refob/herculitoHardware/README.md

# herculitoHardware
 Decription of the hardware used by the herculito robot arm
 
 The herculito hardware consists of:
 * [Wemos D1 R32](/Wemos%20D1%20R32/README.md)
 * [CNC Shield V3](/CNC%20Shield%20V3/README.md)
 * [Extension board](/Extension/README.md)
 * [InterConn board](/InterConn/README.md)
 * [controlBox](/controlBox/README.md)
 * [Display](/Display/README.md)
 * [TMC2209 driver](/TMC2209/README.md)
 * [Connectors used by the herculito robot arm](/connectors/README.md)
 
 The 3D printable sources are available for download at [UltiMaker Thingiverse](https://www.thingiverse.com/thing:6422152).
