refob/herculitoHardware/controlBox/README.md

# controlBox

### BOM
* 1x [DC Power Plug Male 5.5x2.1mm Type C](https://www.aliexpress.com/item/1005003324016159.html)
* 1x [AC/DC switch-mode power supply 230V to 12V 10A 120W](https://www.ebay.de/itm/386404788570)
* 1x [Fan 50x50x15 mm](https://www.aliexpress.com/item/1005003960311498.html)

Solder power cables to the power plug

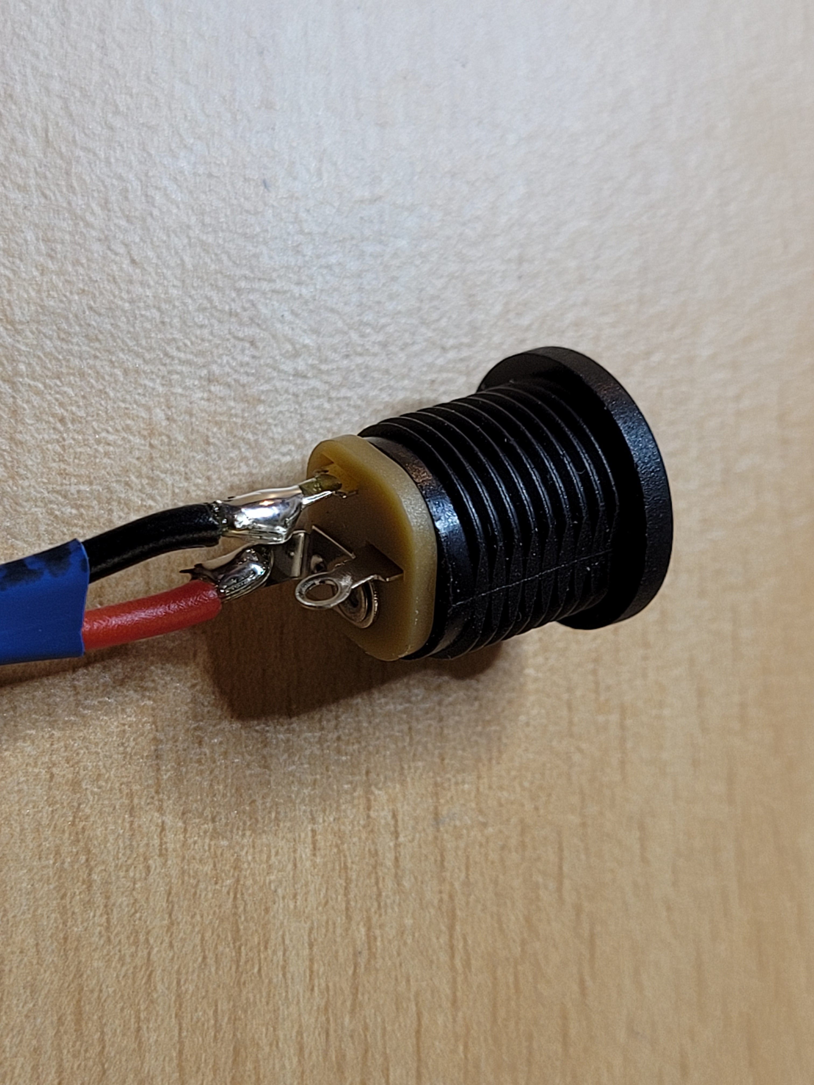
[picture p1: controlBox/power1.jpg]
power1


Fix the power plug to the controlBox

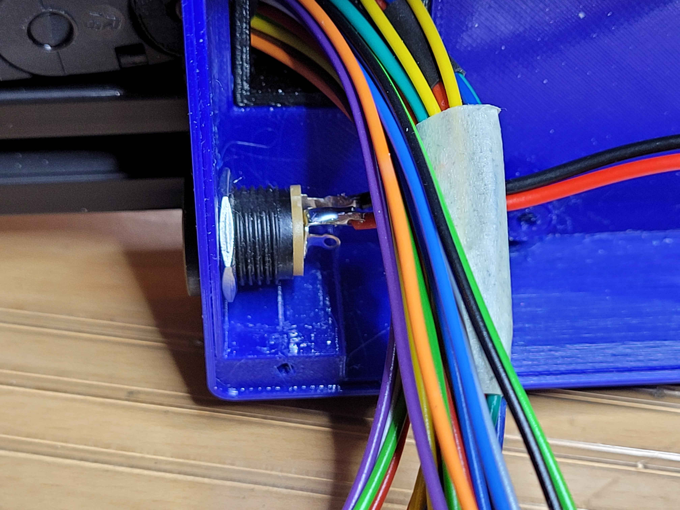
[picture p2: controlBox/power2.jpg]
power2


Place the InterConn

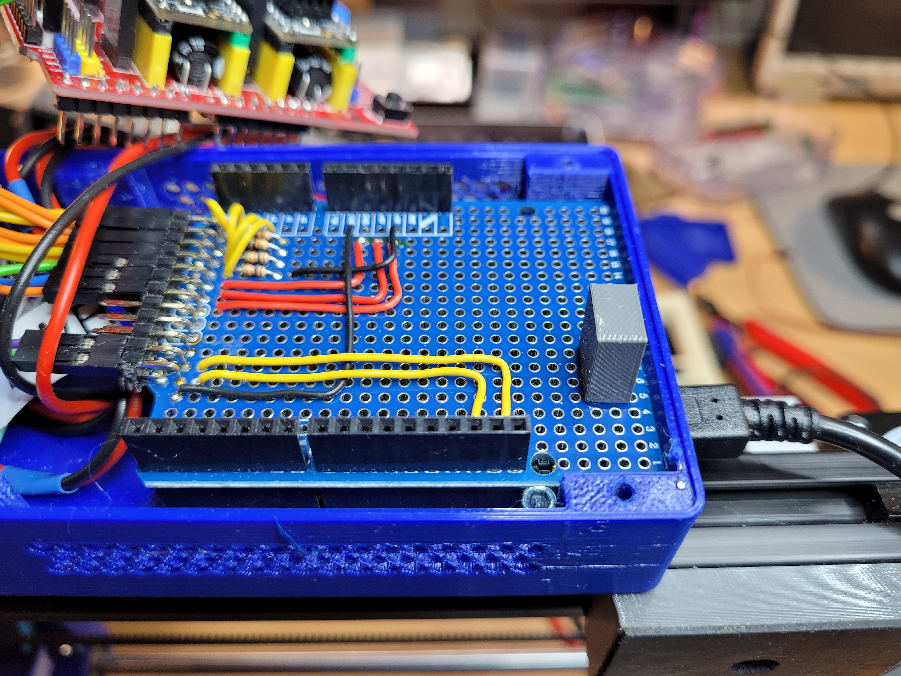
[picture p3: controlBox/place InterConn.jpg]
place InterConn


Place the CNC shield

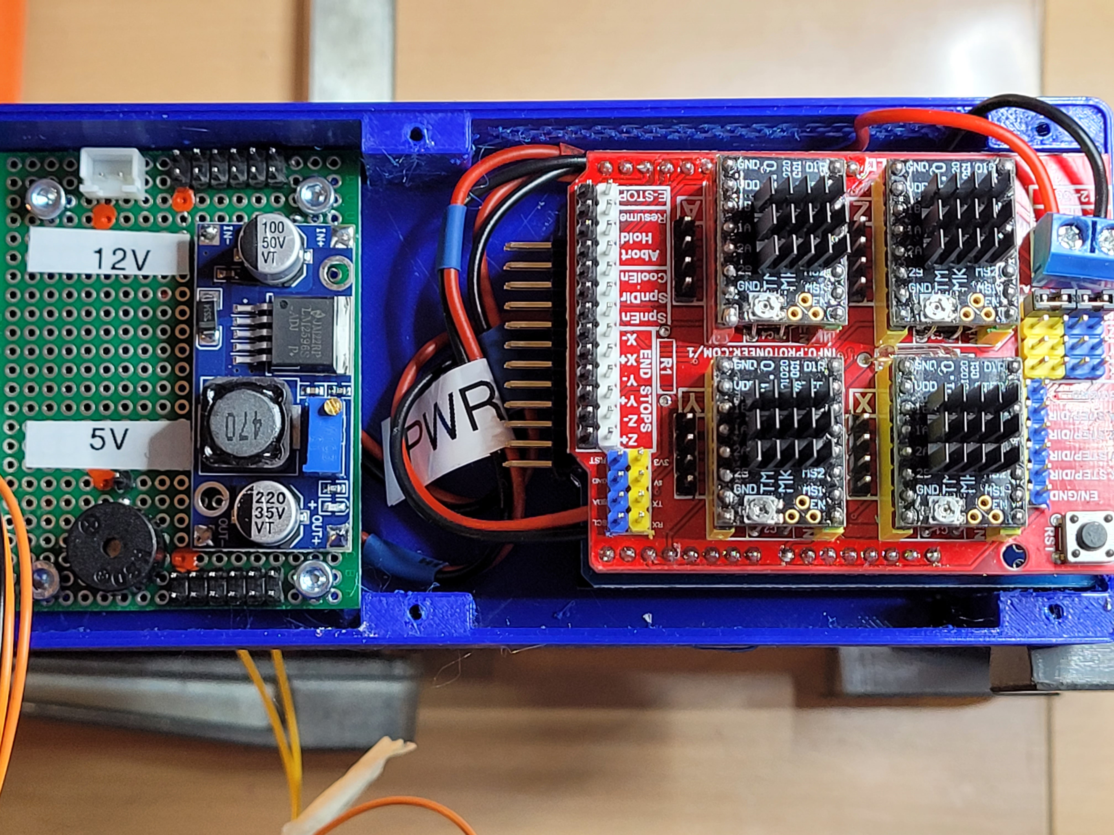
[picture p4: controlBox/place CNC SHield.jpg]
place CNC SHield


Place the drivers

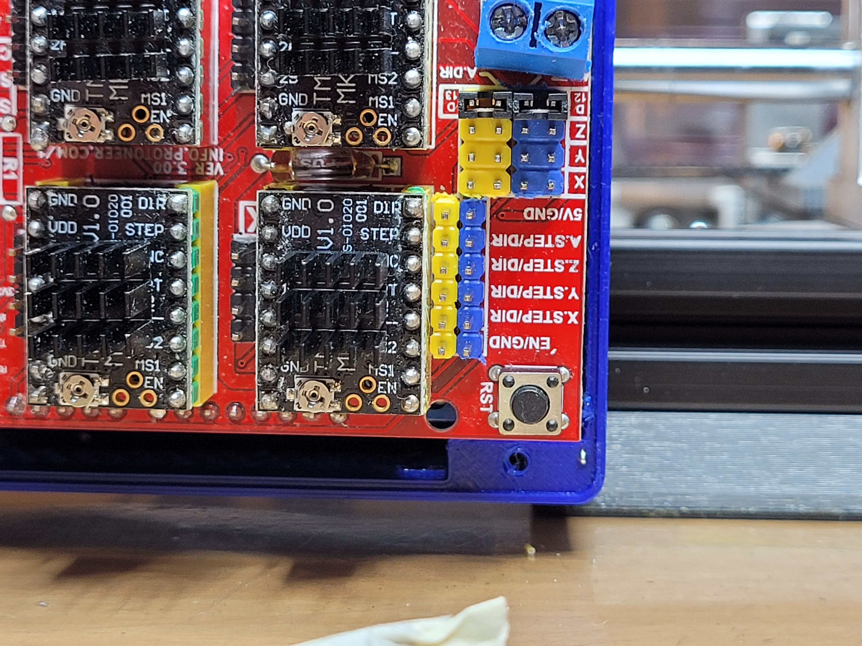
[picture p5: controlBox/place driver.jpg]
place driver


Place the Extensions

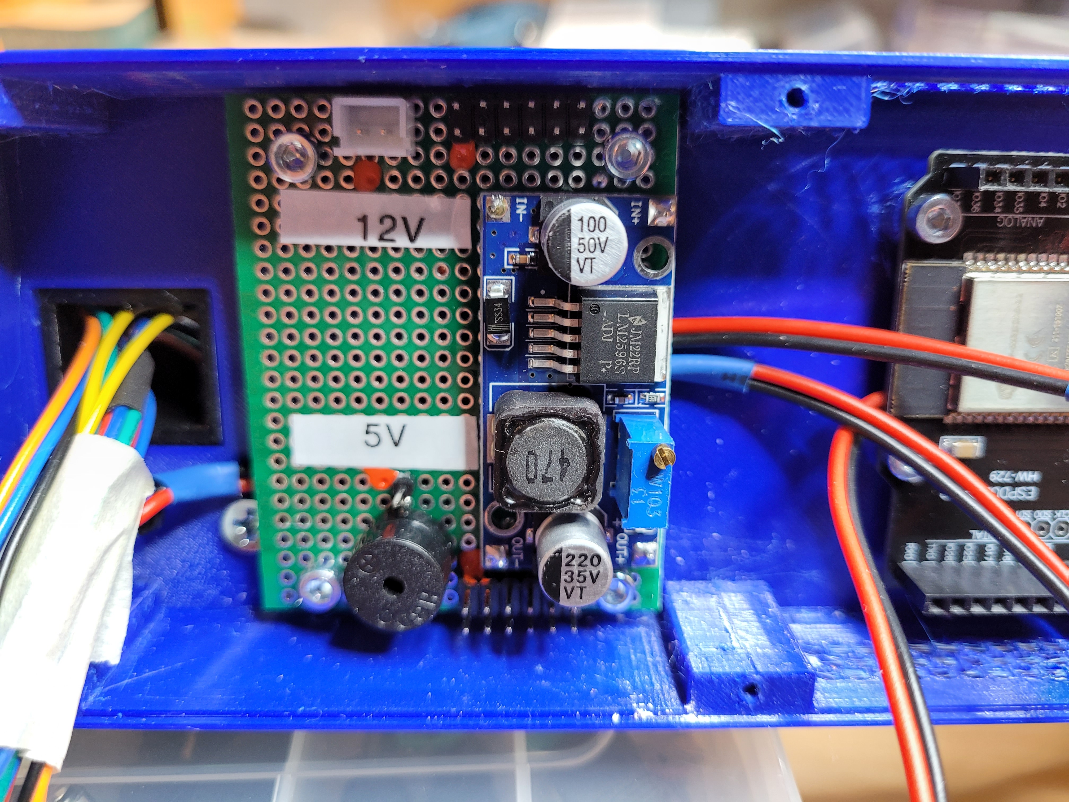
[picture p6: controlBox/place Extensions 1.jpg]
place Extensions


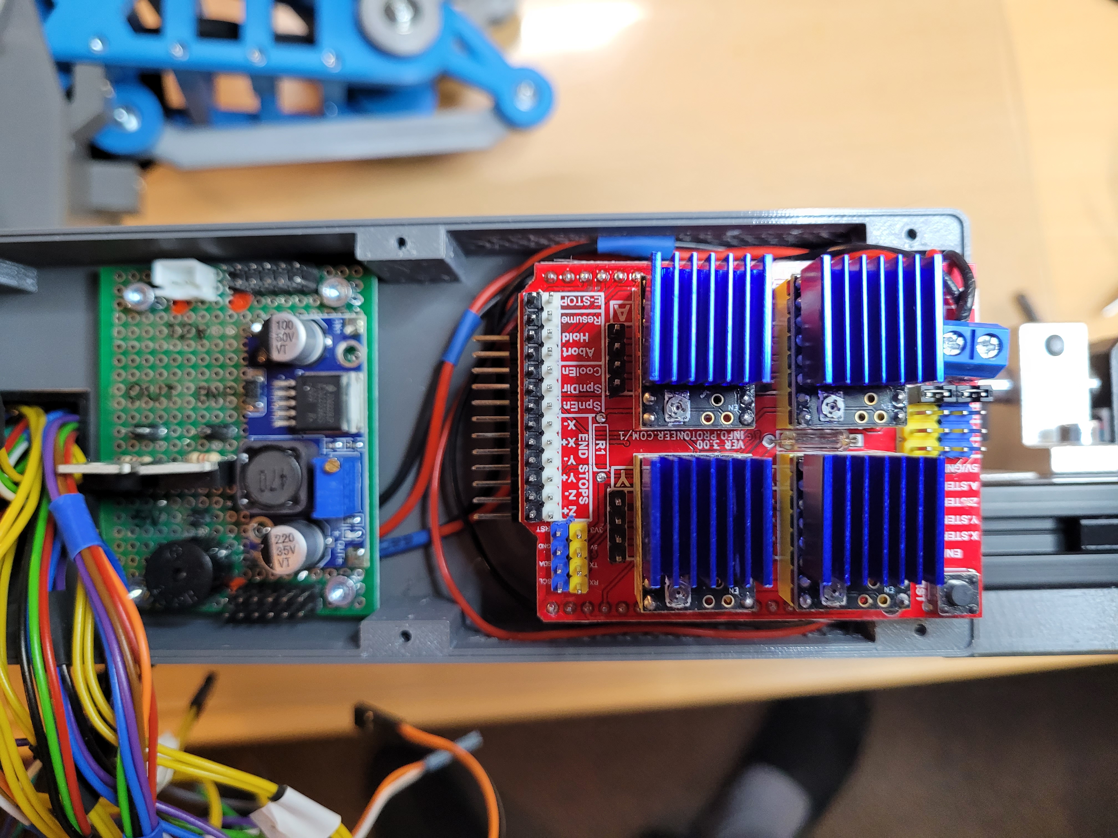
[picture p7: controlBox/place Extensions 2.jpg]
place Extensions


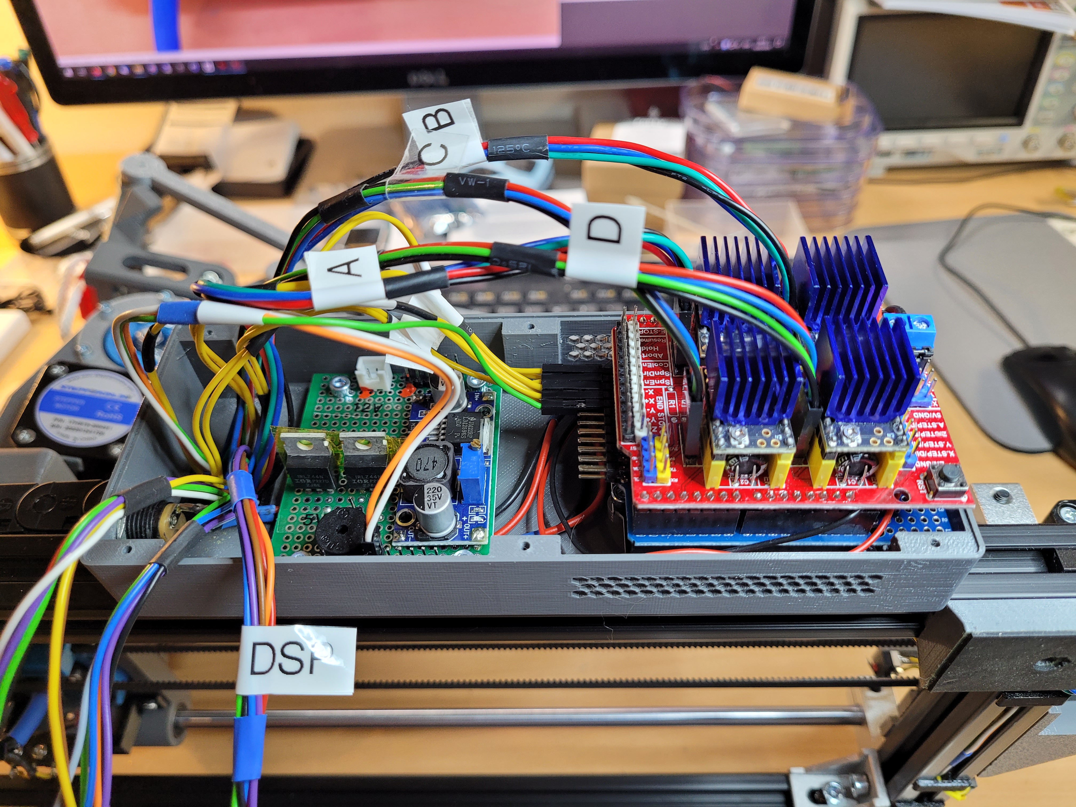
[picture p8: controlBox/place Extensions 3.jpg]
place Extensions


Locate the reset button on the lower right

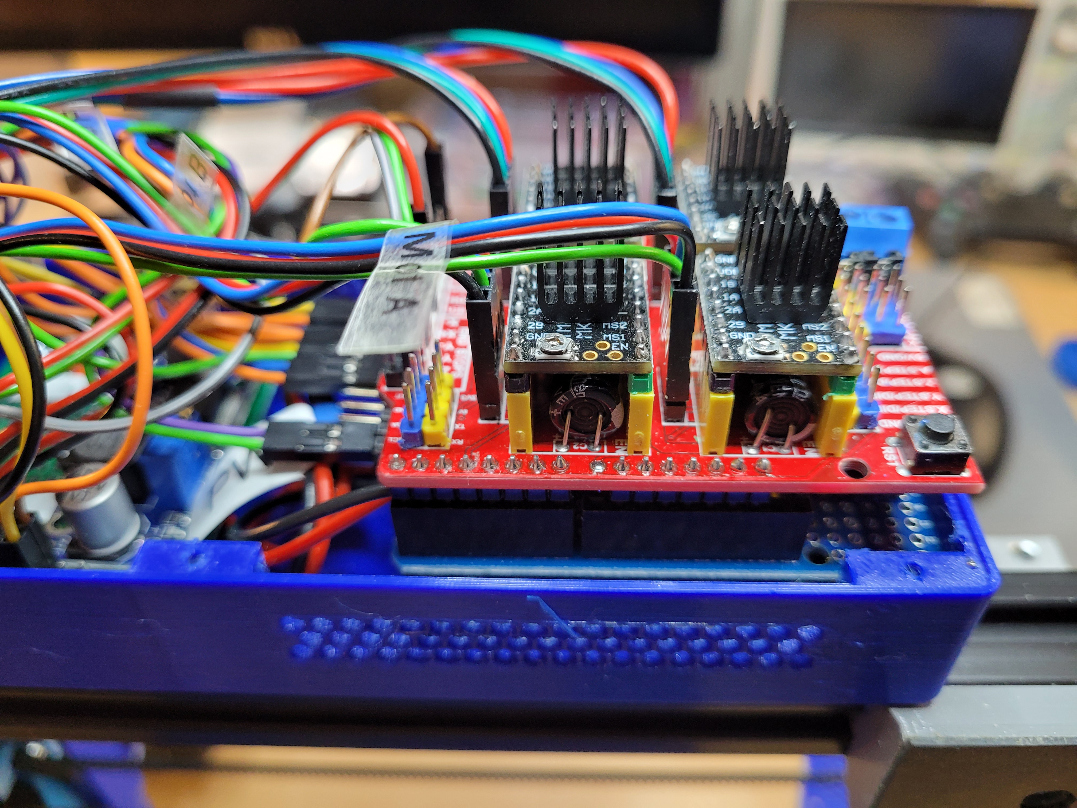
[picture p9: controlBox/reset1.jpg]
reset1


Place the controlBox-reset on the reset button before closing the controlBox

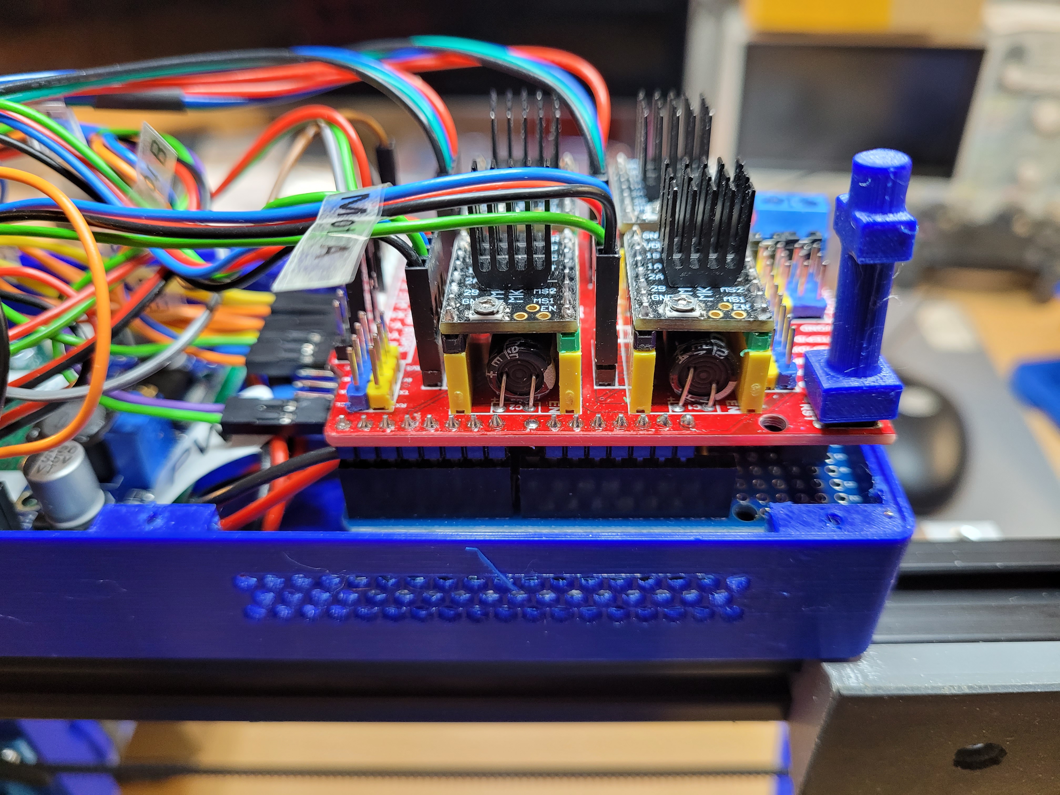
[picture p10: controlBox/reset2.jpg]
reset2


controlBox with all boards mounted and cables equipped with Dupont connectors

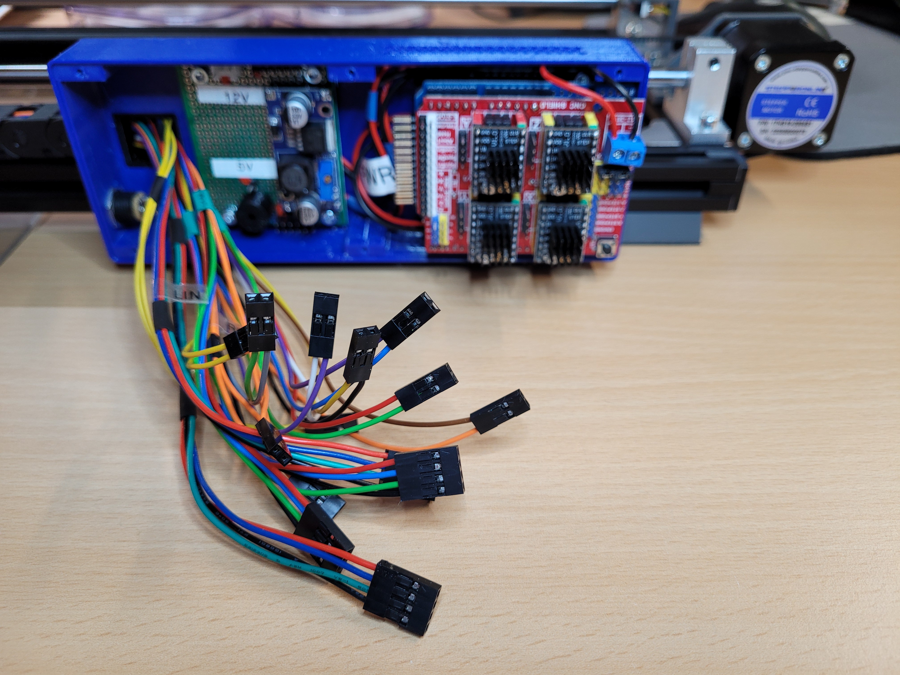
[picture p11: controlBox/cables.jpg]
cables
