refob/herculitoHardware/Extension/README.md

# Extension Board 

### BOM

* 1x [Breadboard: 50 x 62 mm](https://www.aliexpress.com/item/1005004818919331.html)
* 1x [LM2596 Step-down Module (adjusted to 5.0V)](https://www.aliexpress.com/item/32653212622.html)
* 1x [Active Buzzer 3V](https://www.aliexpress.com/item/1005004005677478.html)
* 2x [2.54mm Double Row Male Pin Header 2x6](https://www.aliexpress.com/item/1005006142829300.html)
* 1x [2.54mm Single Row Male Pin Header 1x1](https://www.aliexpress.com/item/1005001514058091.html)
* 1x [JST XH2.54 2 Pin Terminals Plastic Shell Male Plug](https://www.aliexpress.com/item/1005003422202370.html)

Schematic
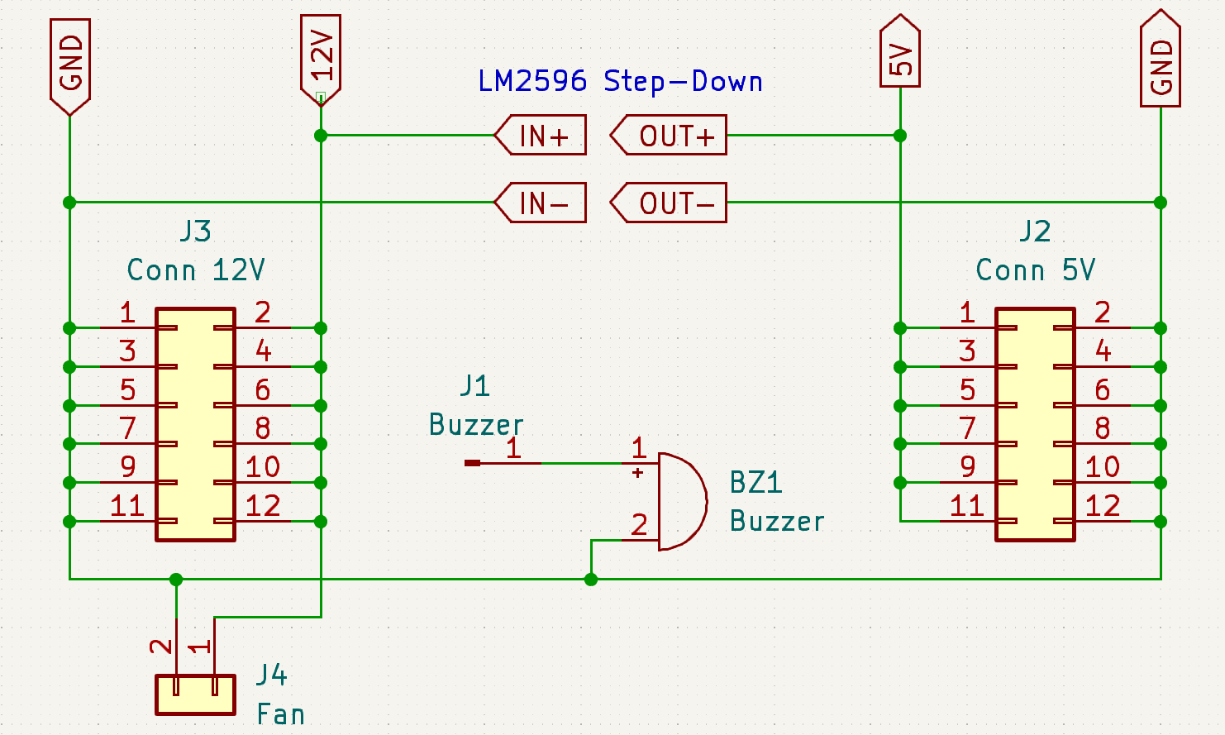
[picture p12: KiCad/Extension/Extension.png]
Schematic


Front side
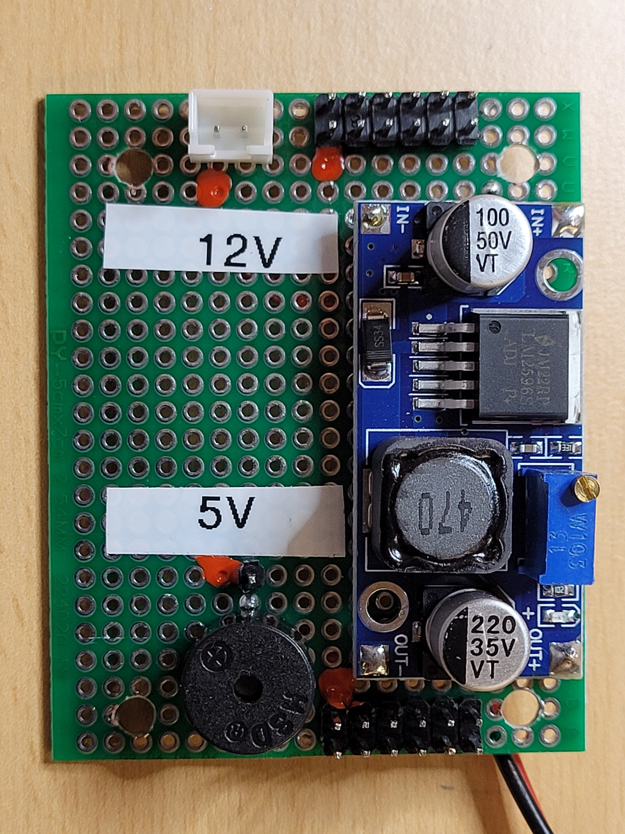
[picture p13: Extension/01.jpg]


Back side
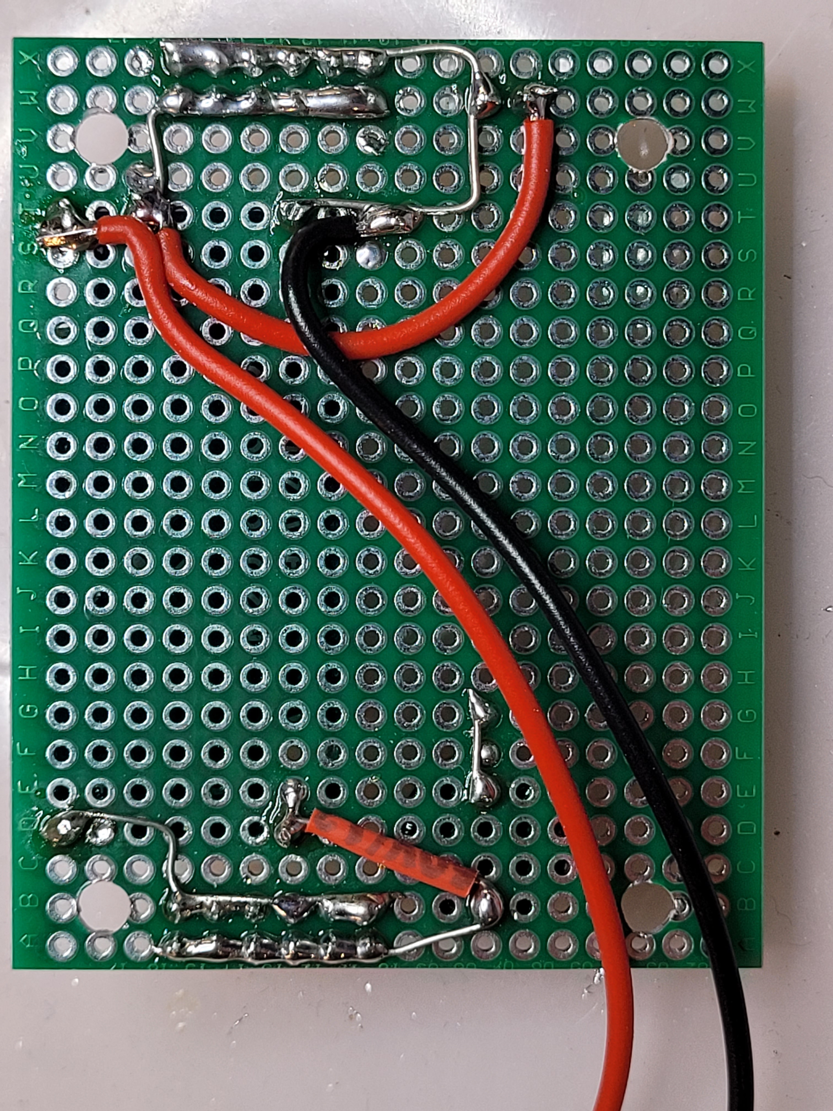
[picture p14: Extension/02.jpg]


MOS Switch Extension
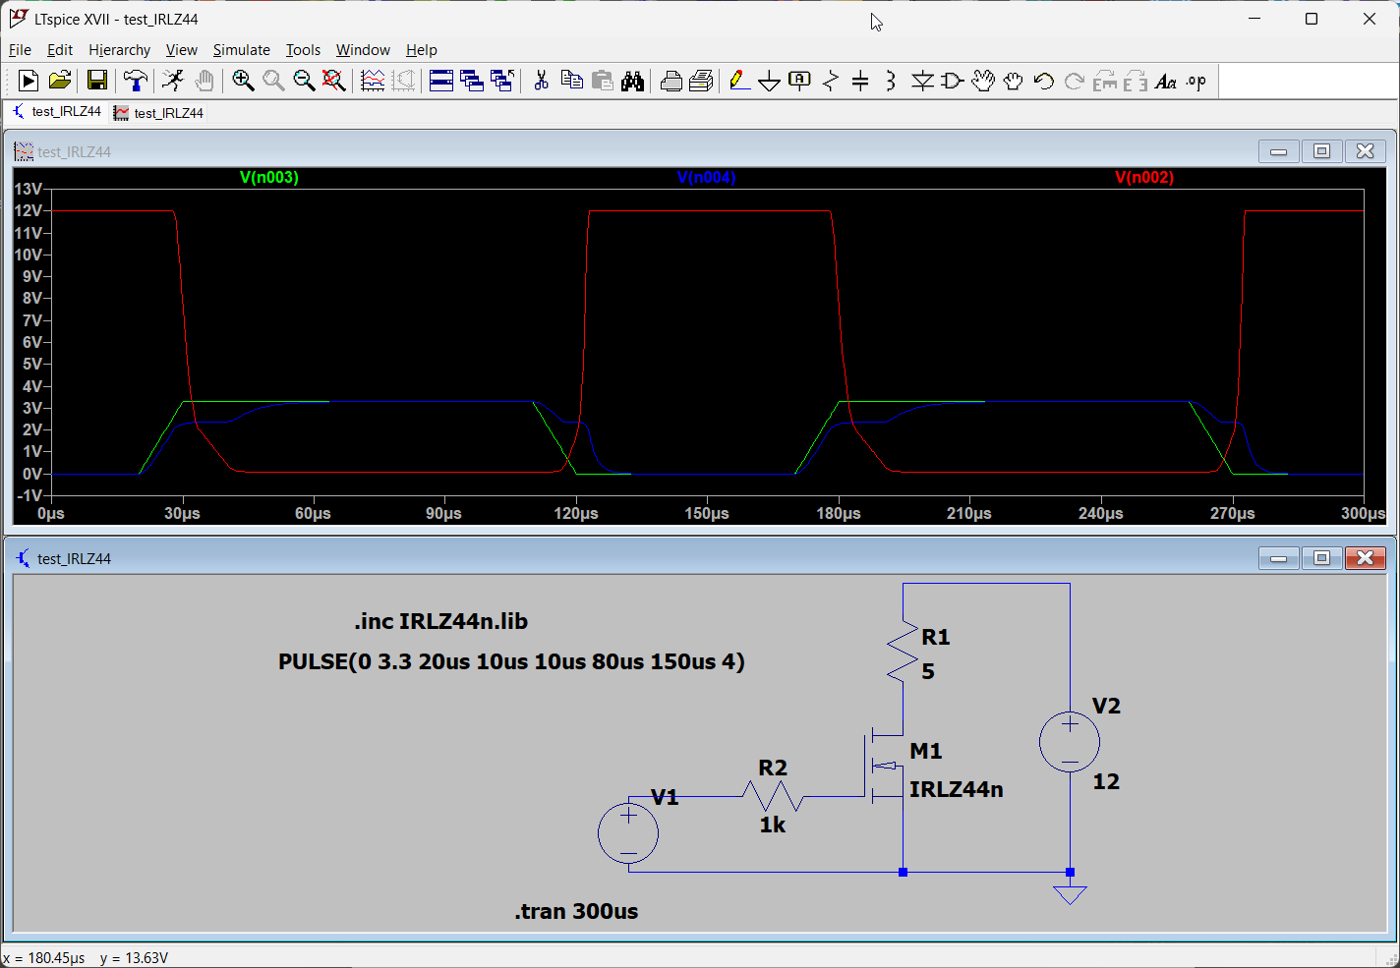
[picture p15: Extension/MOS_Switch.png]


Front side V2 (incl. 2 MOS switches)
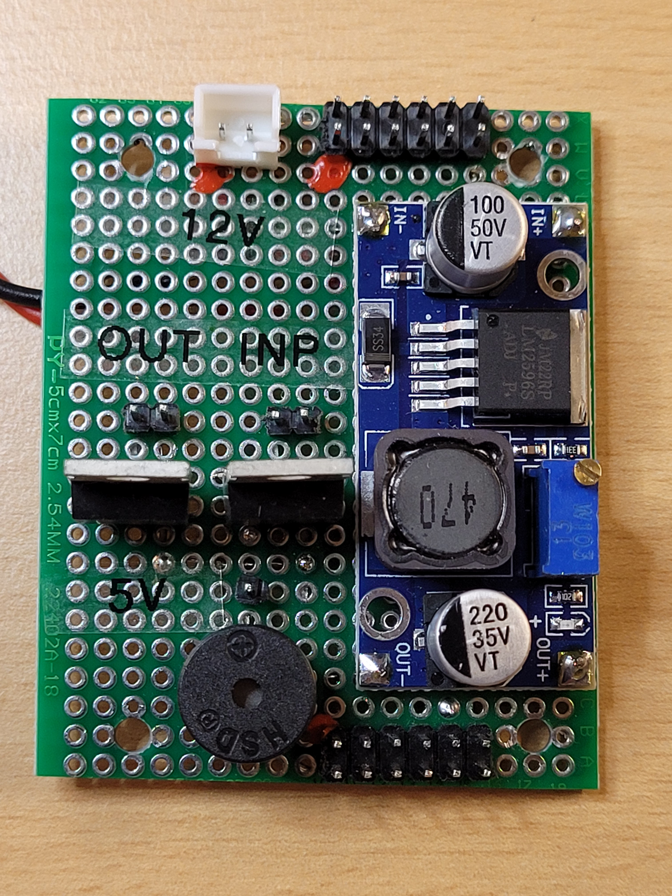
[picture p16: Extension/04.jpg]


Back side V2 (incl. 2 MOS switches)
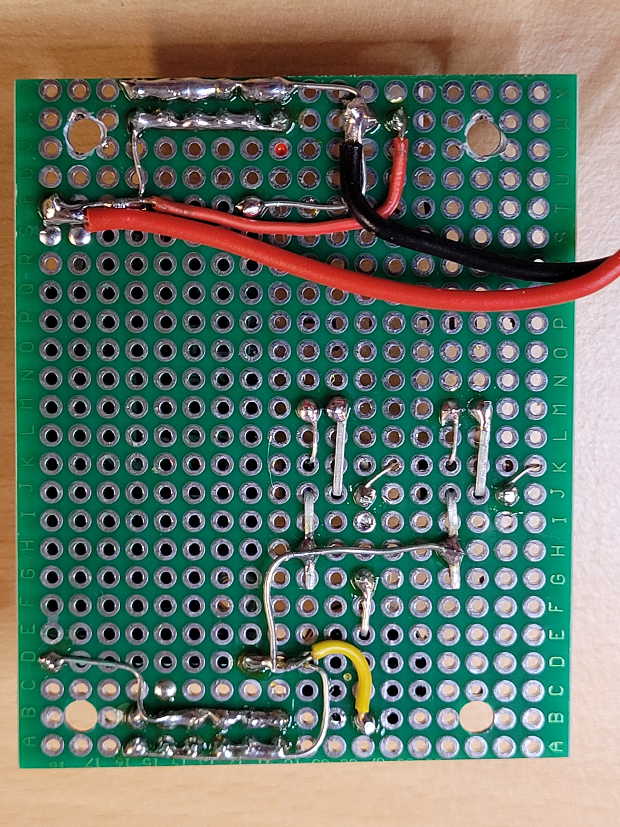
[picture p17: Extension/05.jpg]


Extension board build into the controlBox
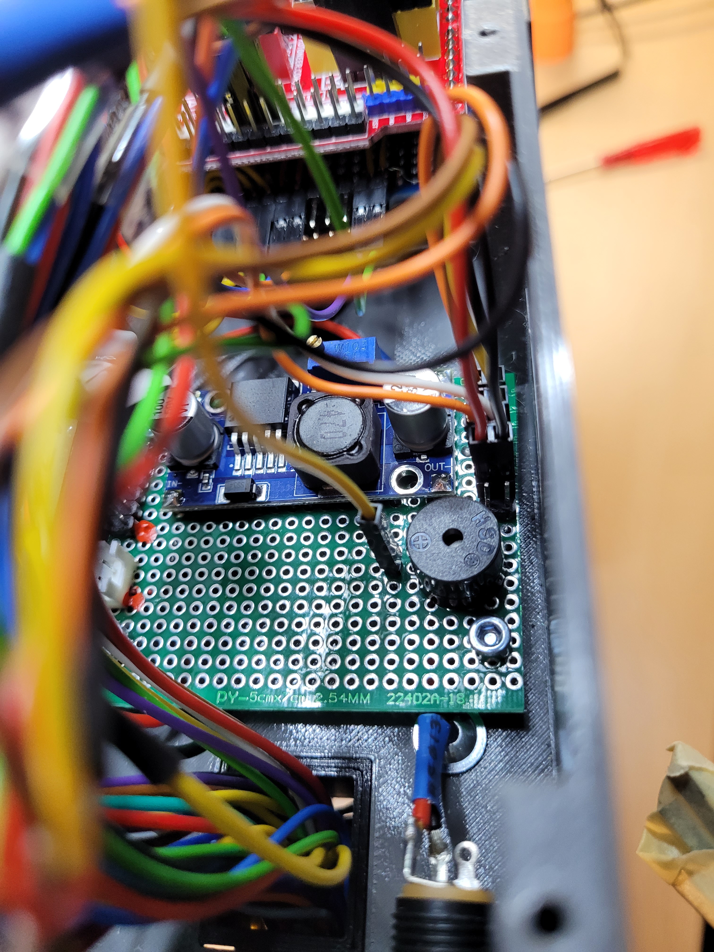
[picture p18: Extension/03.jpg]
Buildin
