refob/herculitoHardware/CNC Shield V3/README.md

# CNC Shield V3

 The Wemos D1 R32 board controls the CNC Shield V3.0. This works fine,
 if A4988 drivers are used on the shield.

<pre>
rst:0x1 (POWERON_RESET),boot:0x13 (SPI_FAST_FLASH_BOOT)<CR>
configsip: 0, SPIWP:0xee<CR>
clk_drv:0x00,q_drv:0x00,d_drv:0x00,cs0_drv:0x00,hd_drv:0x00,wp_drv:0x00<CR>
mode:DIO, clock div:1<CR>
load:0x3fff0018,len:4<CR>
load:0x3fff001c,len:1216<CR>
ho 0 tail 12 room 4<CR>
load:0x40078000,len:10944<CR>
load:0x40080400,len:6388<CR>
entry 0x400806b4<CR>
</pre>

 Once the A4988 drivers are exchanged with TMC2209 boards I observed The
 following error:

<pre>
rst:0x10 (RTCWDT_RTC_RESET),boot:0x33 (SPI_FAST_FLASH_BOOT)<CR>
invalid header: 0xffffffff<CR>
invalid header: 0xffffffff<CR>
invalid header: 0xffffffff<CR>
invalid header: 0xffffffff<CR>
invalid header: 0xffffffff<CR>
invalid header: 0xffffffff<CR>
invalid header: 0xffffffff<CR>
ets Jul 29 2019 12:21:46<CR>
<CR>
</pre>

 This seems to be caused by a higher load that the TMC2209 drivers put on the 
 GPIO12 port, which status is critcal during the ESP32 boot.
 
 The TMC2209 drivers keep cool during operation and run the steppers in a very
 silent mode. Therefore I decided to implement a hardware fix:
 
 *Disconnect GPIO12 and the connect ENABLE to the GPIO00 pin that is not used.*
 
 Please also note that the R1 resistor has to be removed from the board, because
 it connected to +5V level that is too high for the ESP32 which allows a maximum
 of 3V3 for its ports.
 
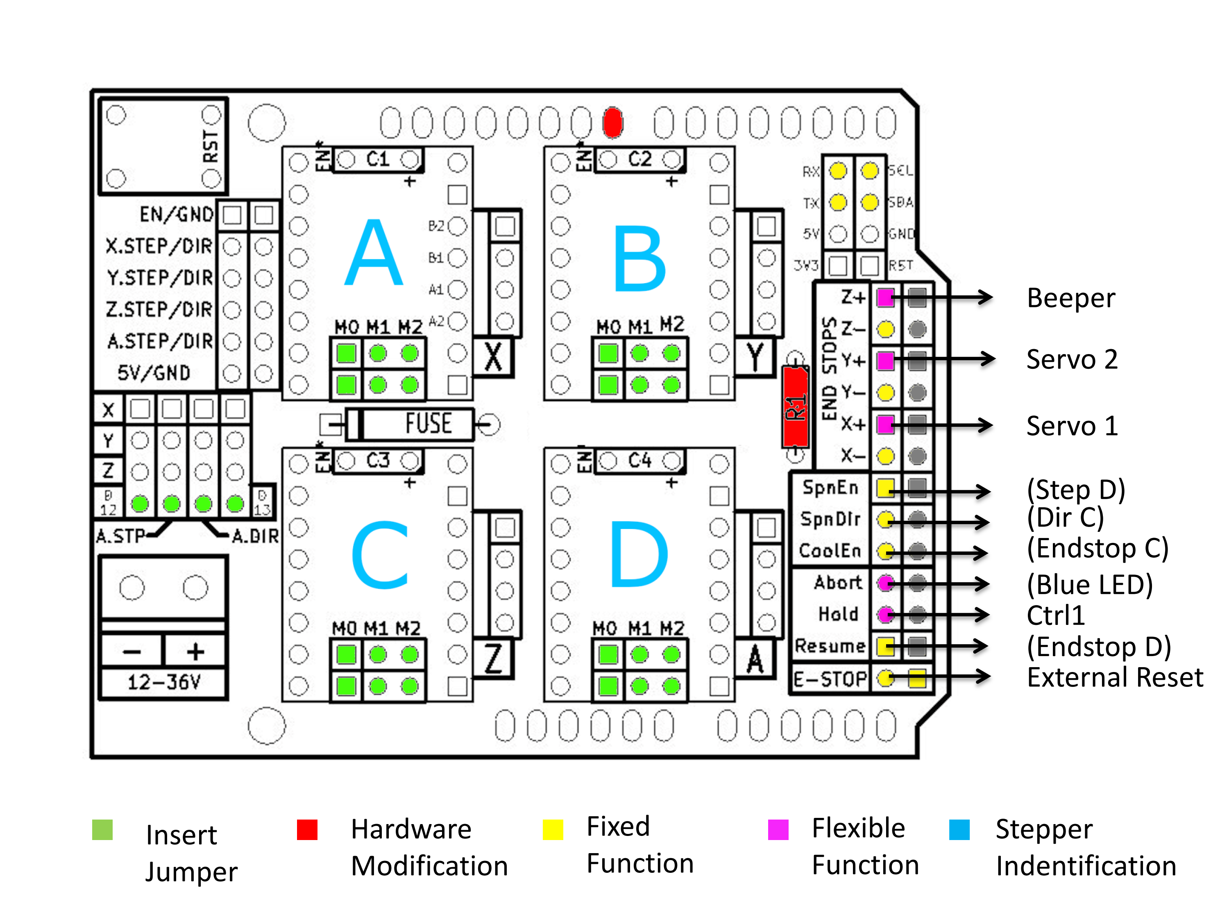
[picture p19: CNC Shield V3/CNC Shield Modifications.png]
Hardware Modifications


The pin above "ENABLE" has to be removed



View, after the pin was removed

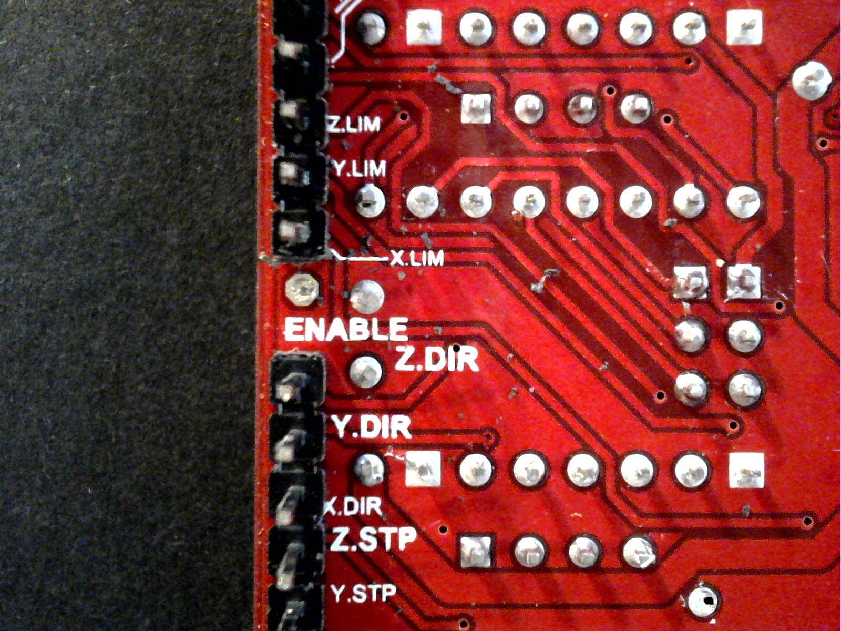
[picture p21: CNC Shield V3/enable b.jpg]

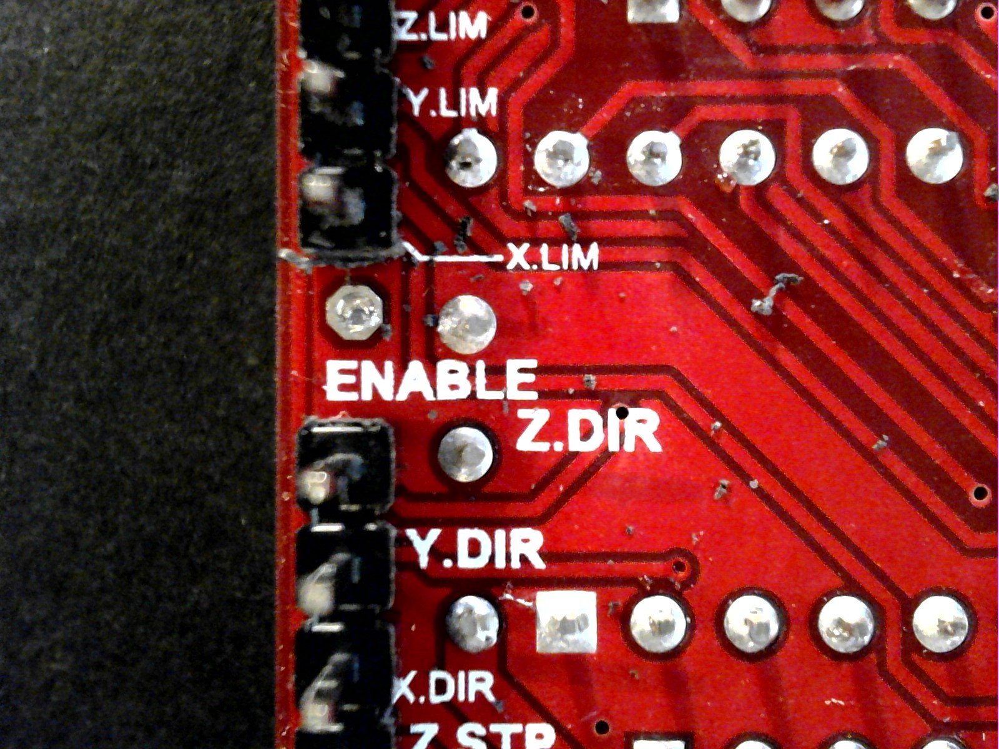
[picture p22: CNC Shield V3/enable c.jpg]


Solder the removed pin to a cable and the solder dot on the pcb board


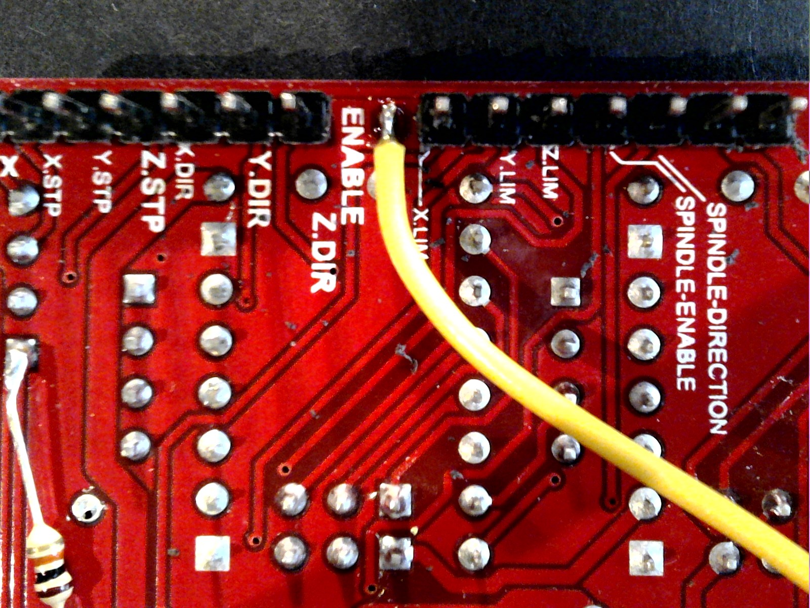
[picture p24: CNC Shield V3/enable e.jpg]

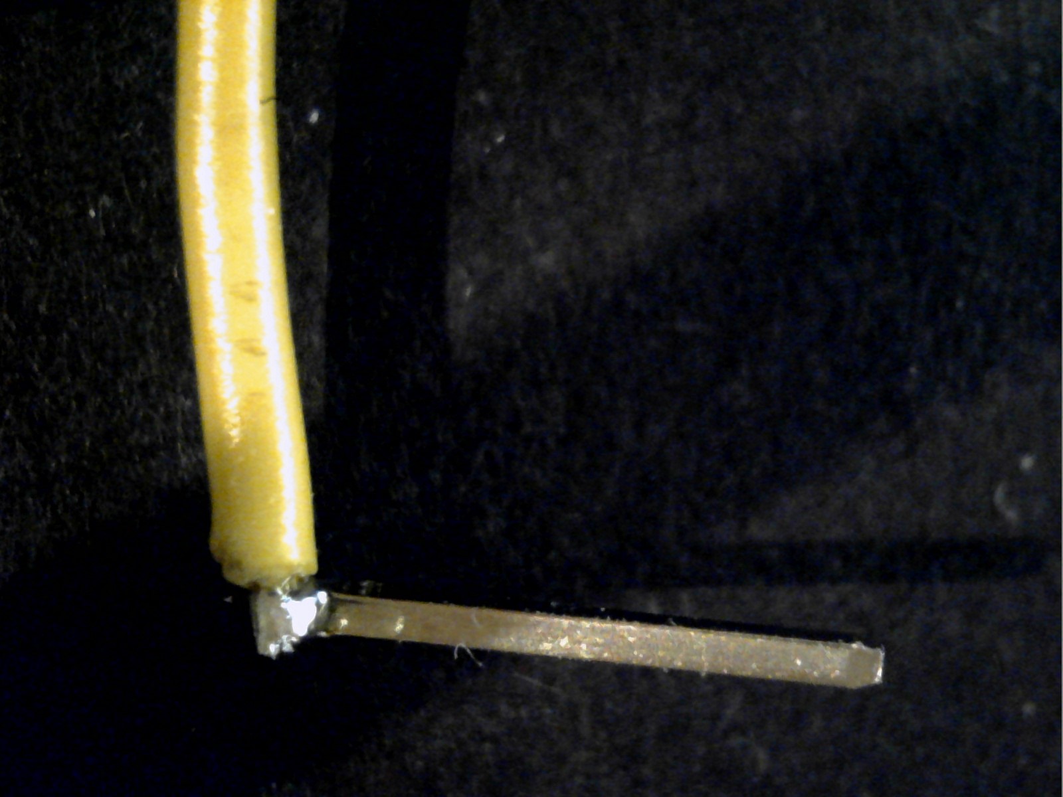
[picture p25: CNC Shield V3/enable f.jpg]


Connect the pin to "IO00" on the Wemos D1 R32 board

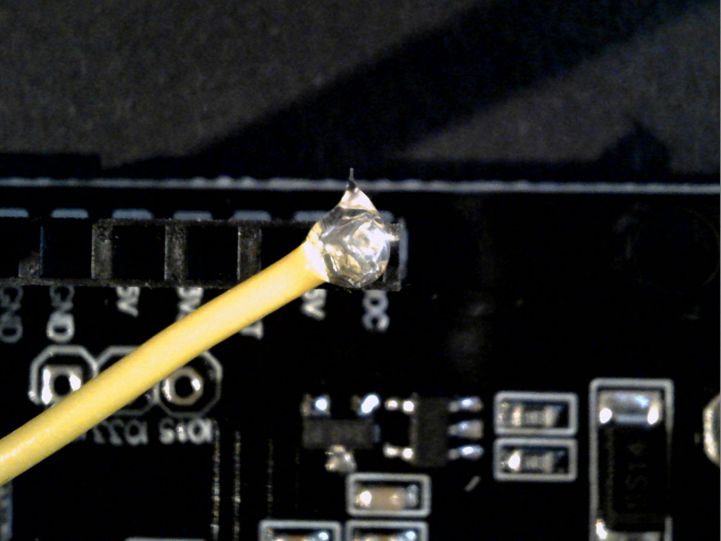
[picture p26: CNC Shield V3/enable g.jpg]


Locate resistor R1 on the CNC shield

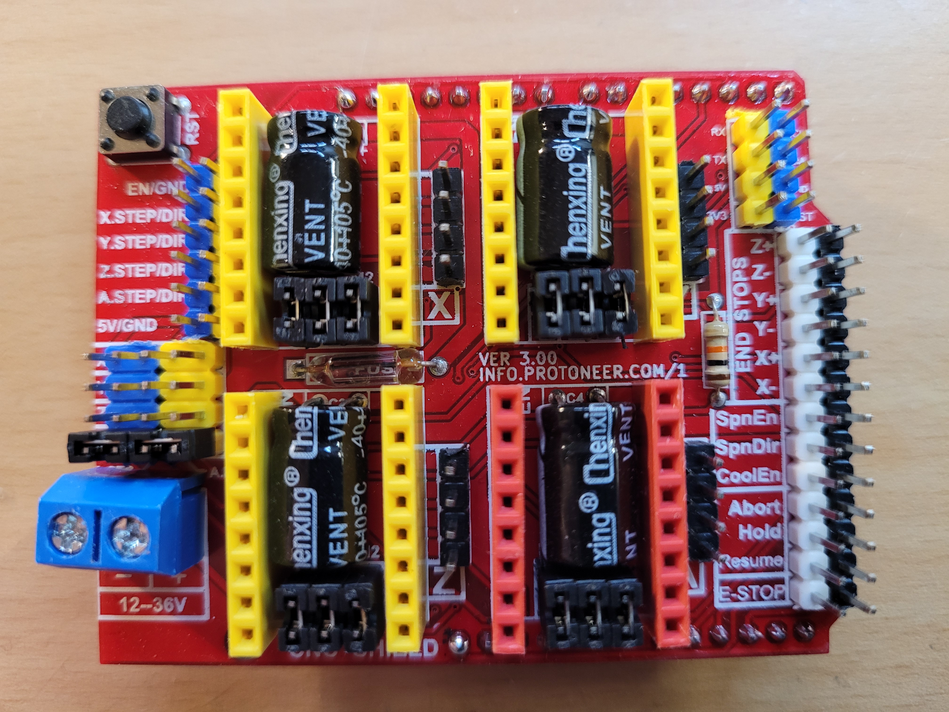
[picture p27: CNC Shield V3/remove R1 a.jpg]


Remove the resistor R1

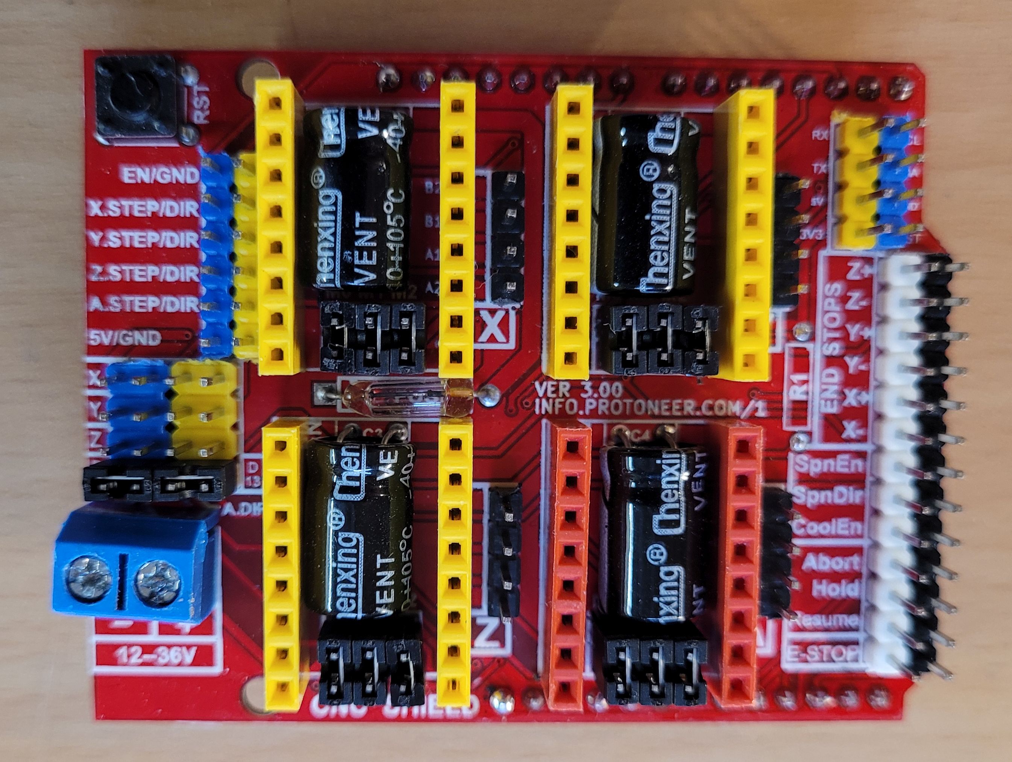
[picture p28: CNC Shield V3/remove R1 b.jpg]


Add a new 10k resistor on the other side of the pcb between the shown solder dots

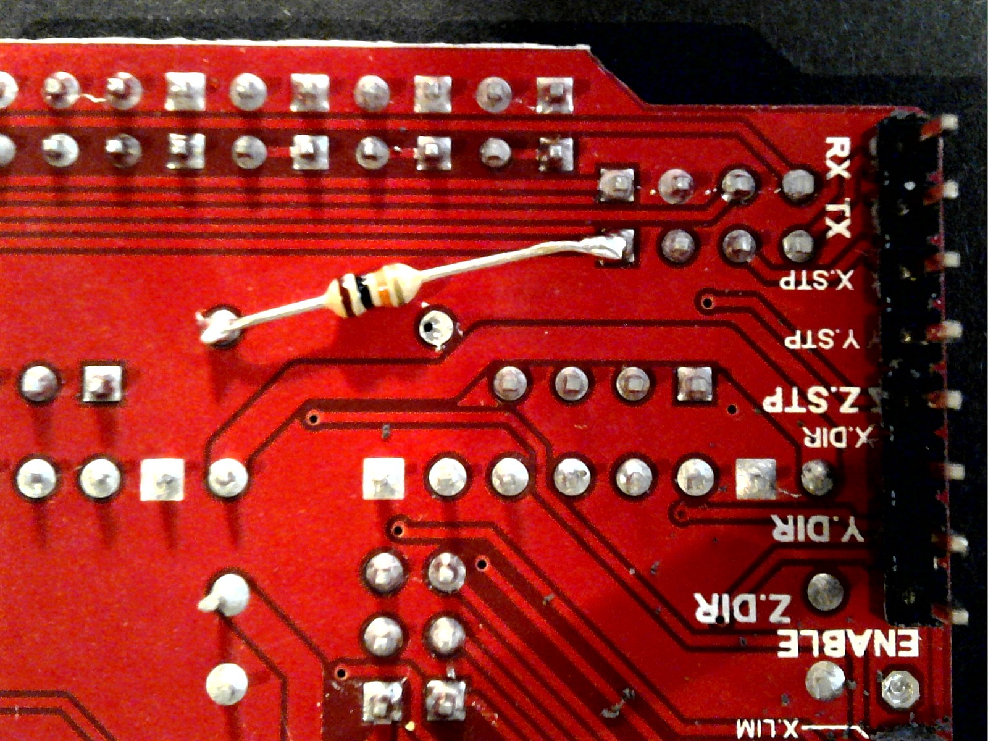
[picture p29: CNC Shield V3/remove R1 c.jpg]


Use two-component adhesive to fix the pin to the correct location

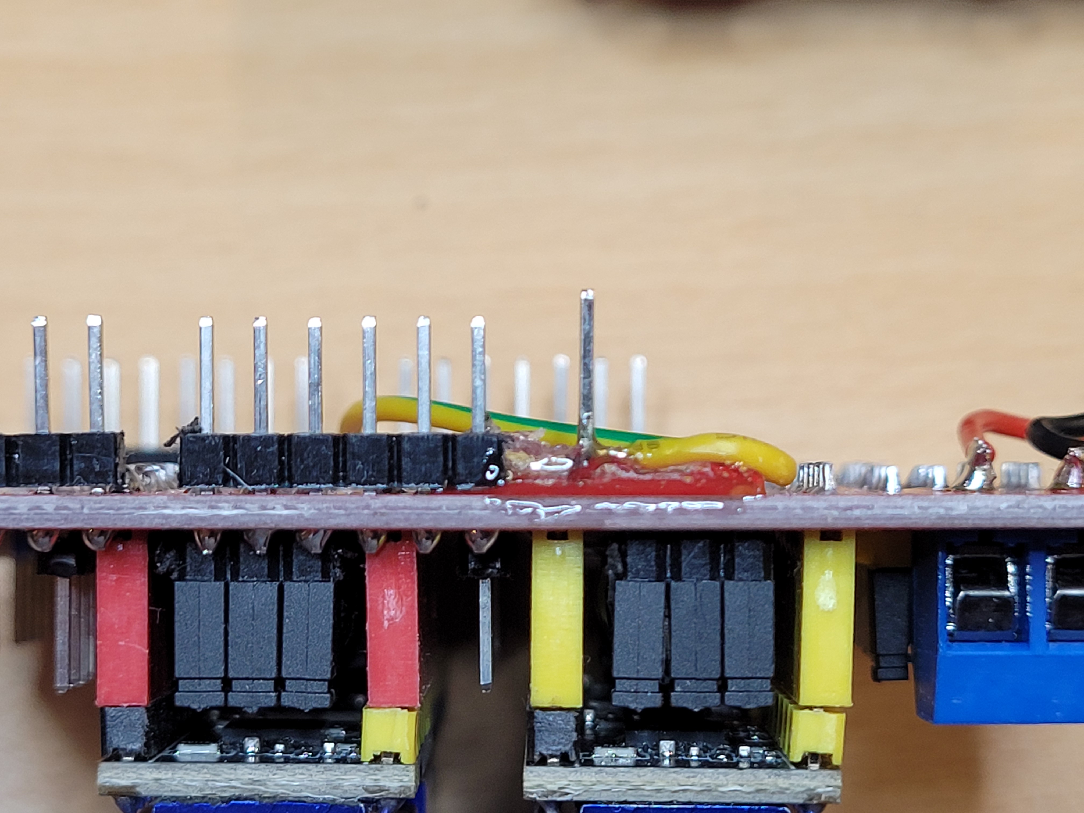
[picture p30: CNC Shield V3/gluePin1.jpg]
gluePin1


Cable and pin fixed

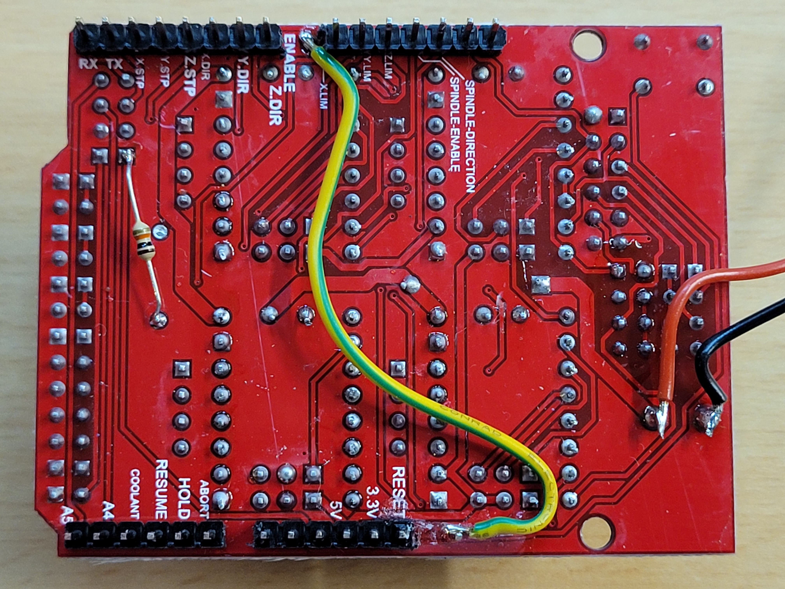
[picture p31: CNC Shield V3/gluePin2.jpg]
gluePin2


Correct alignment of the pin

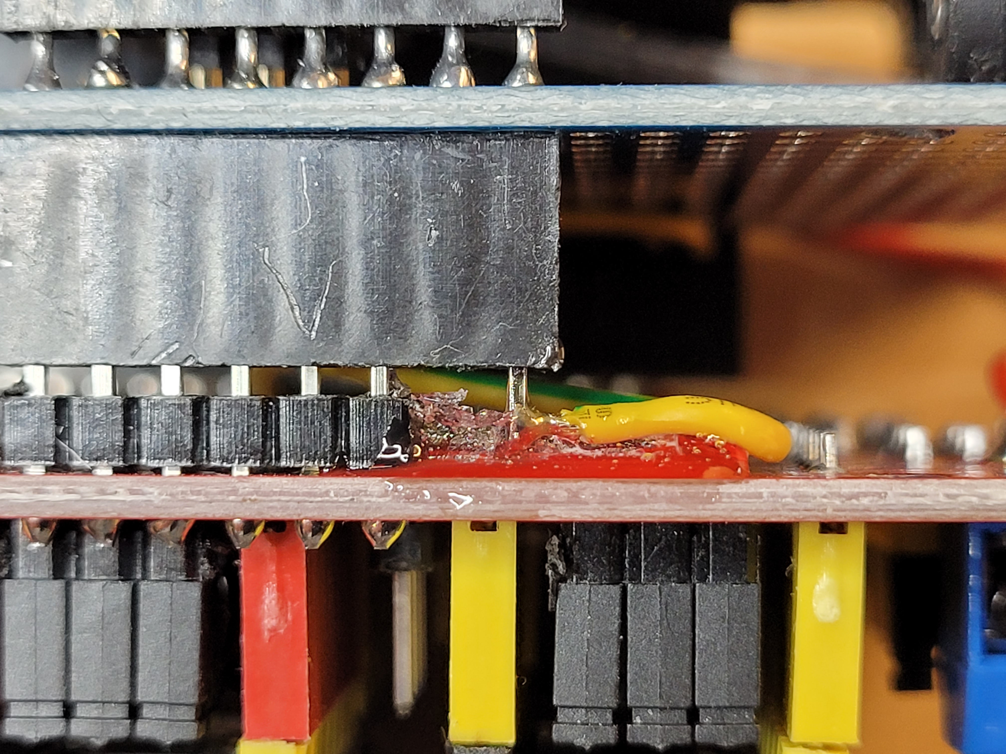
[picture p32: CNC Shield V3/gluePin3.jpg]
gluePin3


CNC shield plugged into InterConn board

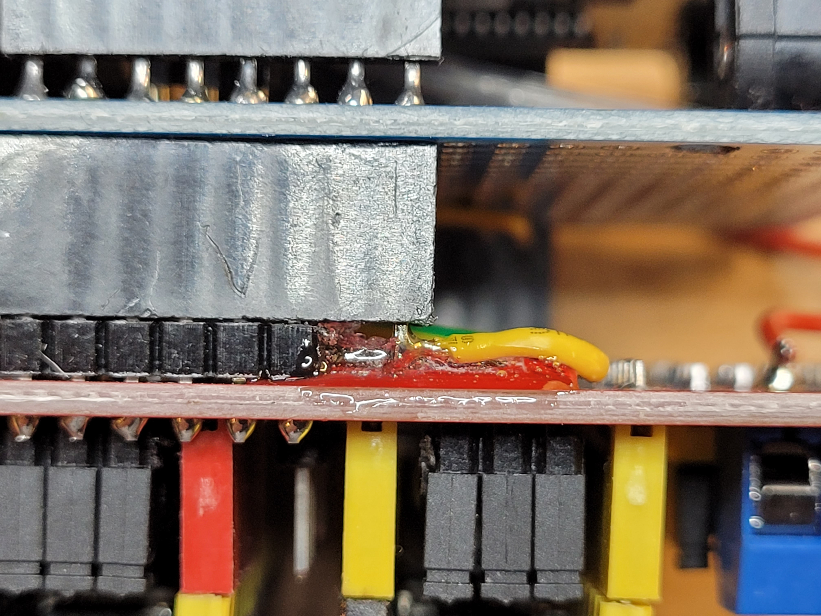
[picture p33: CNC Shield V3/gluePin4.jpg]
gluePin4
