refob/herculitoHardware/InterConn/README.md

# InterConn Board

### BOM
* 1x [Prototype PCB Expansion Board For Arduino](https://www.aliexpress.com/item/1005004015343791.html)
* 1x [90 Degree 2.54mm  Double Row Pin Header 2x12P](https://www.aliexpress.com/item/32848774255.html)
* 1x [2.54mm Pitch 1x3 Pin Male Hole Round Header Strip Connector](https://www.aliexpress.com/item/1005005053790061.html)
* 4x 10k resistor
* 1x 3D printed part ["pcbSpacer.stl"](/InterConn/pcbSpacer.stl)

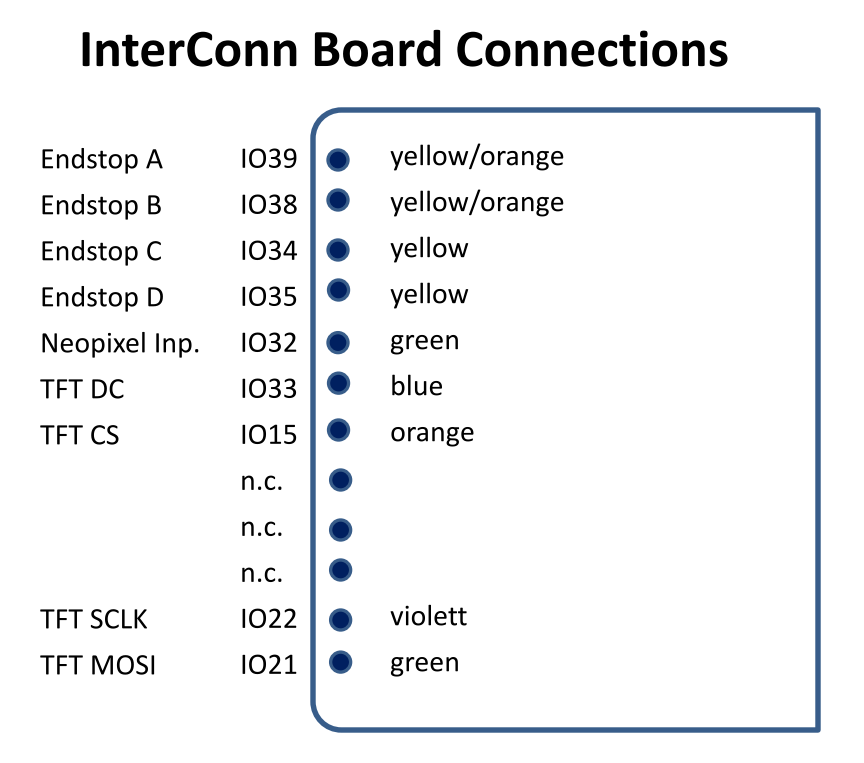
[picture p34: InterConn/Interconn-Top.png]
Interconn-Top


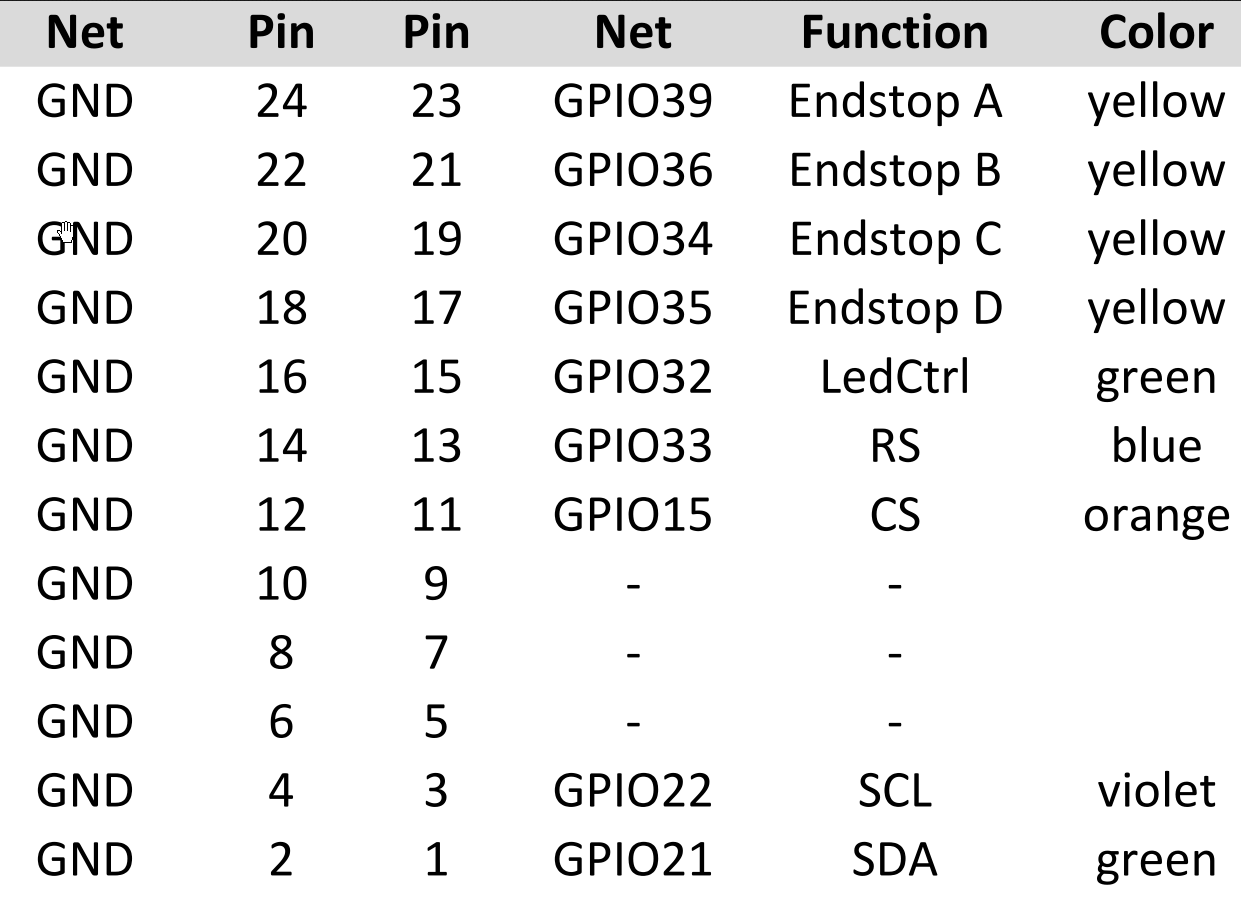
[picture p35: InterConn/InterConn-Connections.png]
InterConn-Connections


InterConn schematic 

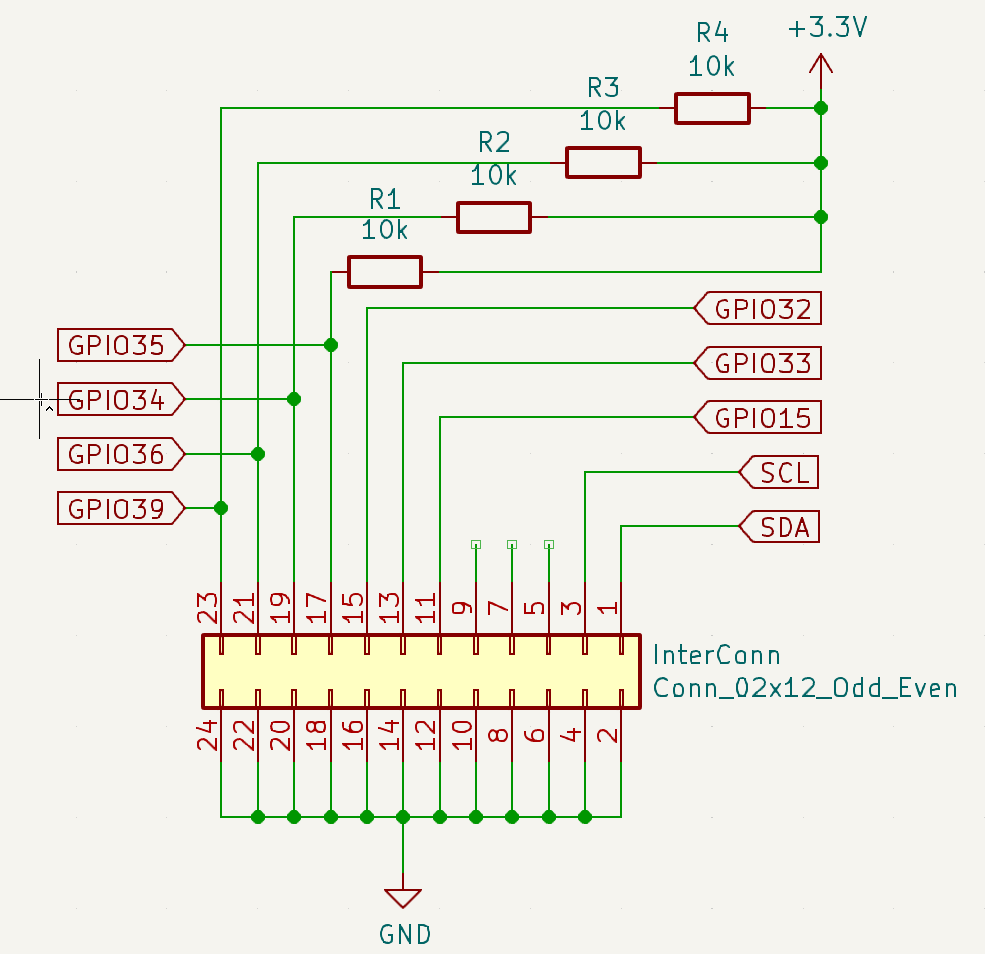
[picture p36: KiCad/InterConn/InterConn.png]
InterConn schematic


InterConn Front

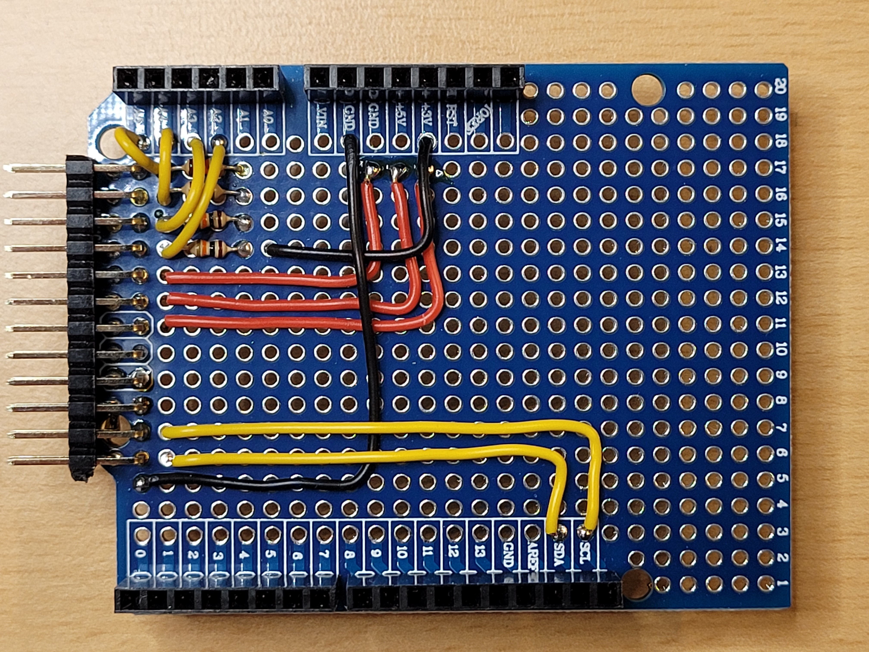
[picture p37: InterConn/InterConn Front.jpg]
InterConn Front


InterConn Back

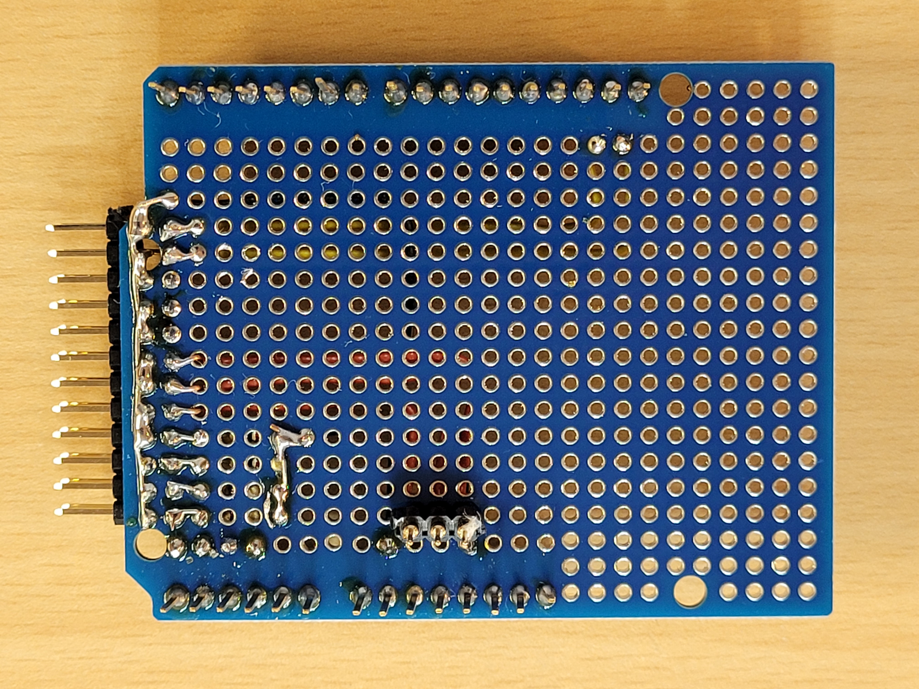
[picture p38: InterConn/InterConn Back.jpg]
InterConn Back


Connector to Wemos D1 R32 board

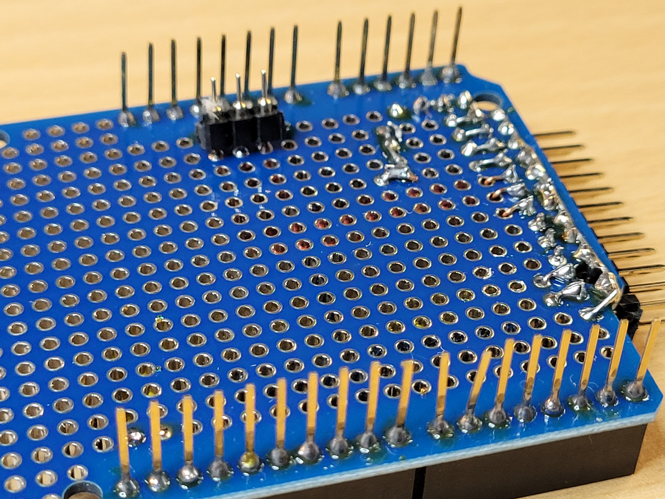
[picture p39: InterConn/3pin a.jpg]
connector


Board aligned with pins

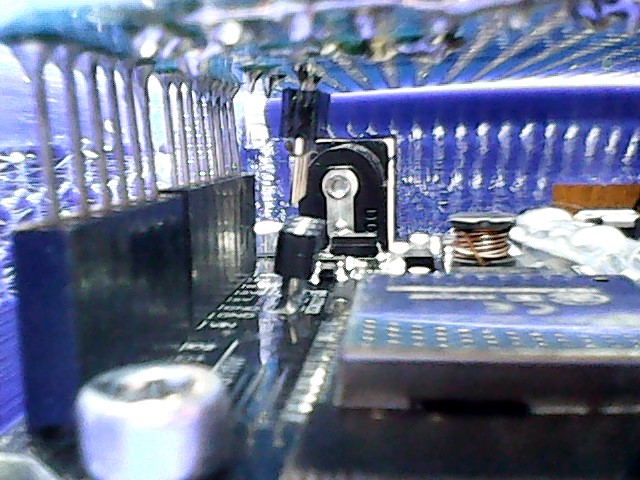
[picture p40: InterConn/3pin b.jpg]
pins alligned


Board 50% pushed down

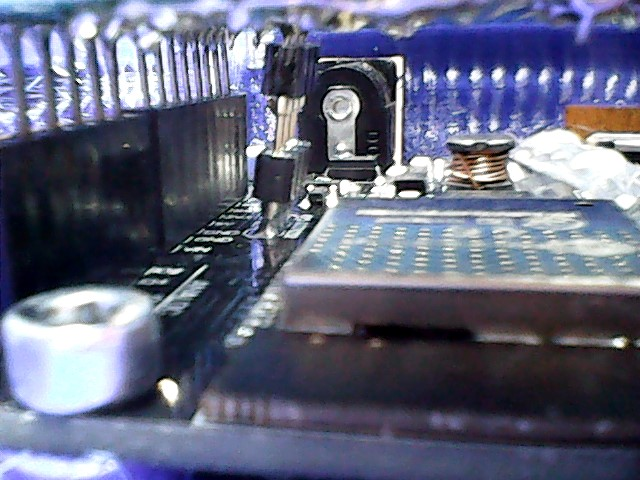
[picture p41: InterConn/3pin c.jpg]
pushed down


Board completely pushed down

pushed down completely

InterConn inside controlBox

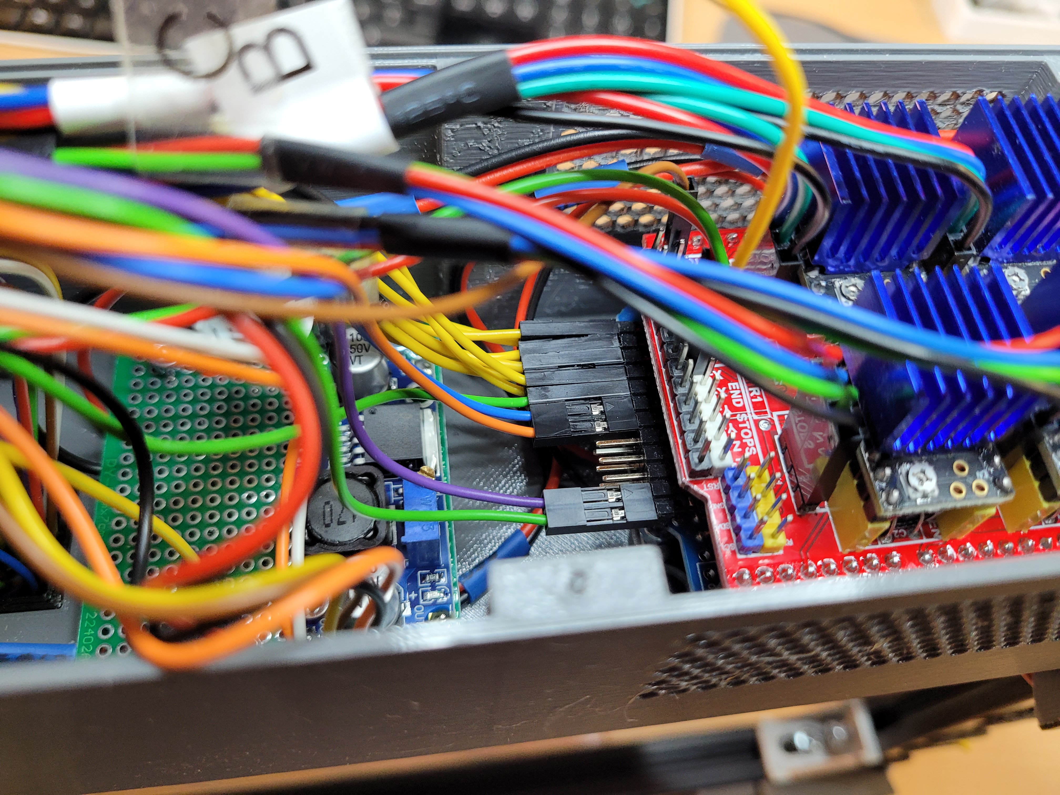
[picture p42: InterConn/InterConn Connections.jpg]
InterConn Connections


Glue the "pcbSPacer.stl" block to the pcb board as shown

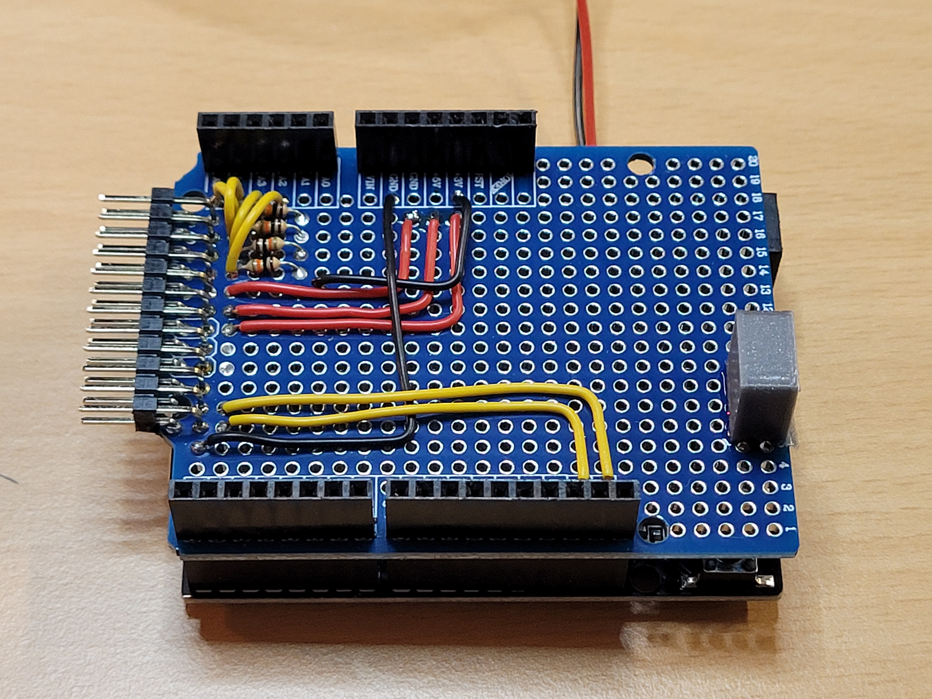
[picture p43: InterConn/pcbSpacer_1.jpg]
spacer placed


"pcbSPacer.stl" block helps to stabilize the CNC board when the reset button is pushed down

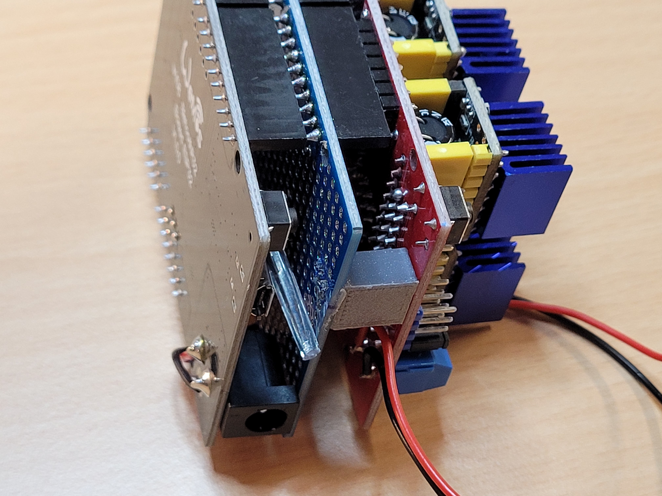
[picture p44: InterConn/pcbSpacer_2.jpg]
spacer placed from side
