refob/herculitoHardware/Wemos D1 R32/README.md

# Wemos D1 R32 Board 

### BOM

* 1x [Wemos D1 R32 Board](https://www.aliexpress.com/item/1005006140622416.html)
* 20cm [Side Glow Fiber Optic Cable 2mm](https://www.aliexpress.com/item/1005003186394069.html)
* 1x 3D printed part ["ledCover.stl"](/Wemos%20D1%20R32/ledCover.stl)

Pin mapping of the Wemos D1 R32 Board

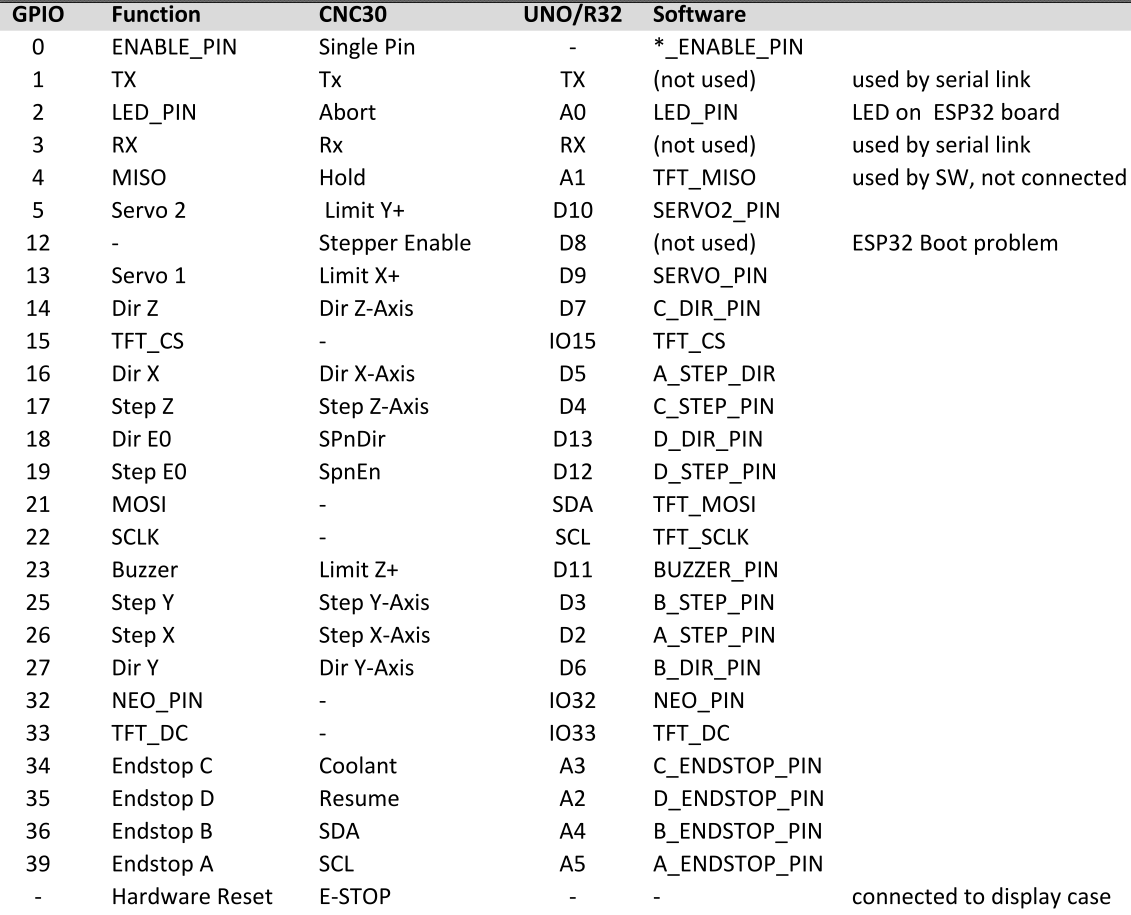
[picture p45: Wemos D1 R32/Weemos CNC30 UNO Mapping.png]
Pin mapping


Solder cables as shown to connect power

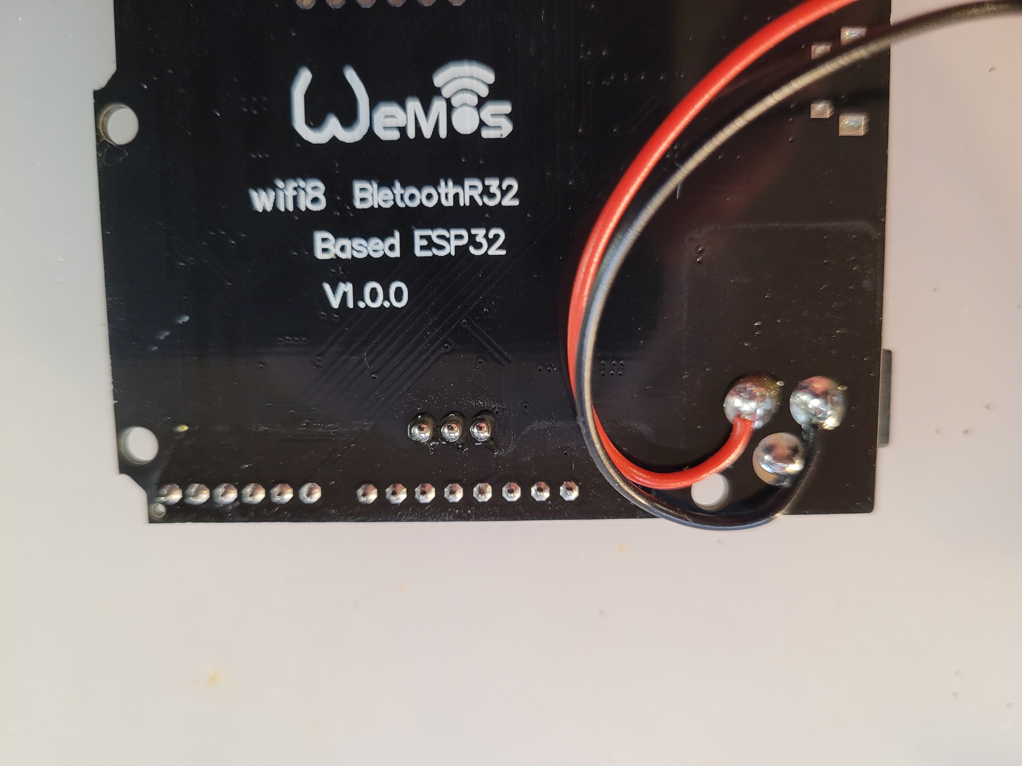
[picture p46: Wemos D1 R32/D1_power_a.jpg]
D1_power_a


D1_power_b


Wemos D1 R32 Board fixed inside controllBox

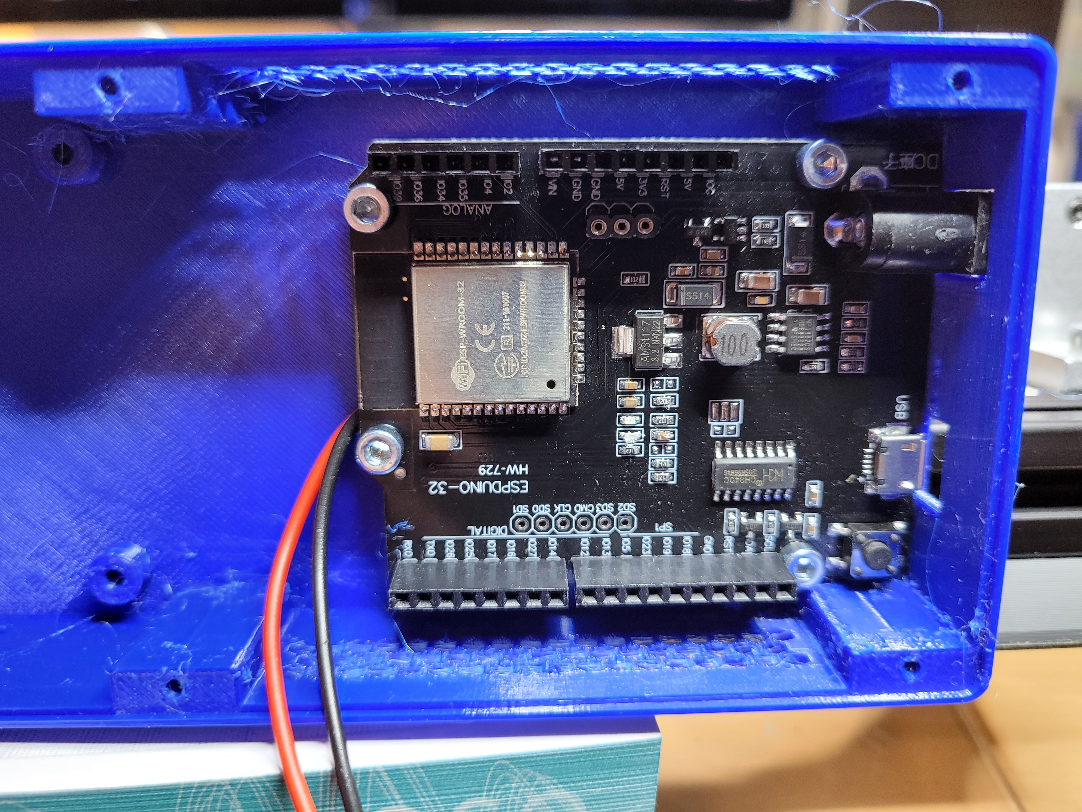
[picture p48: Wemos D1 R32/D1_led_location_a.jpg]
D1_led_location_a


Locations of the two leds

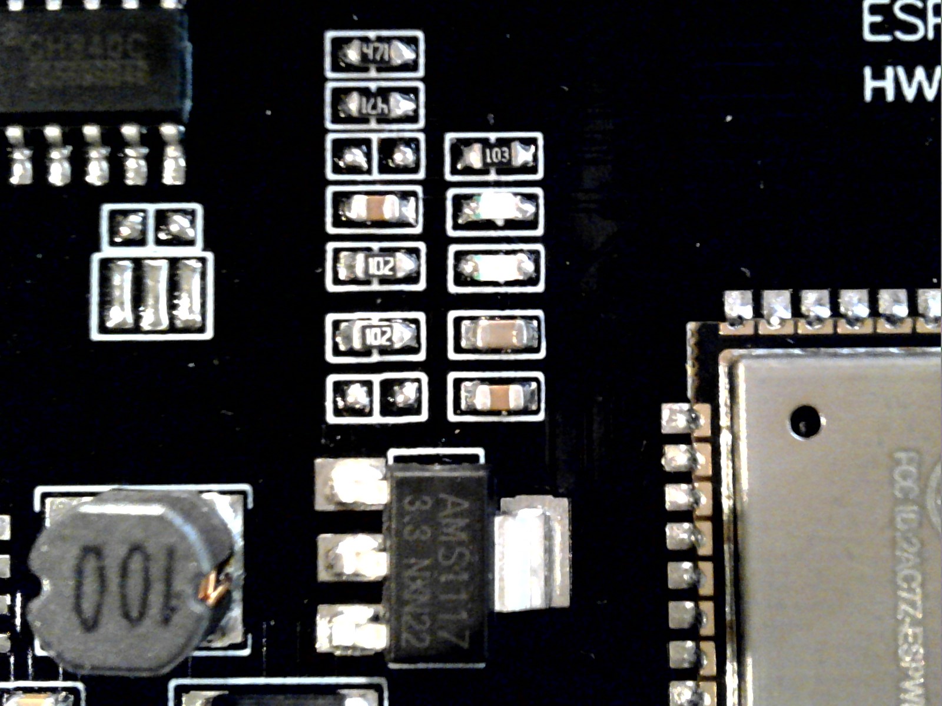
[picture p49: Wemos D1 R32/D1_led_location_b.jpg]
D1_led_location_b


Fix the Fiber Optic cables with masking tape

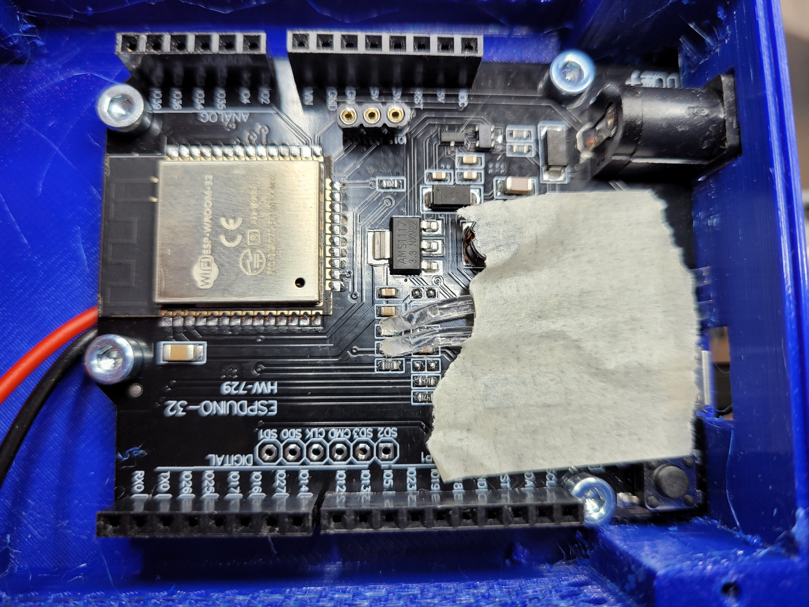
[picture p50: Wemos D1 R32/D1_led_location_c.jpg]
D1_led_location_c


Fix the optic cables on the board with hot glue

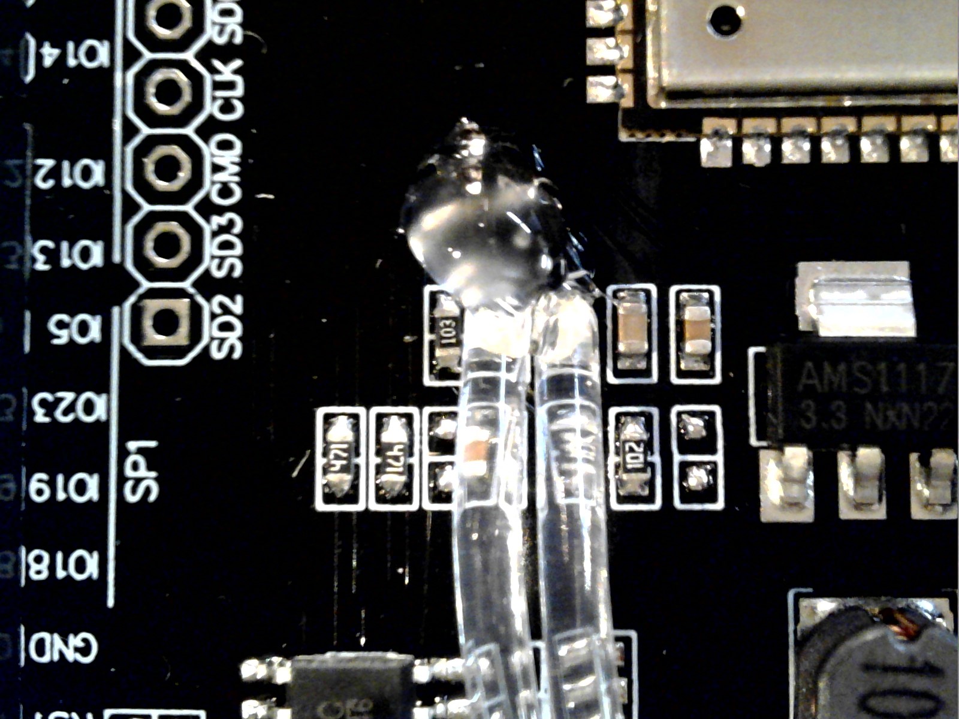
[picture p51: Wemos D1 R32/D1_led_location_d.jpg]
D1_led_location_c


Red led active

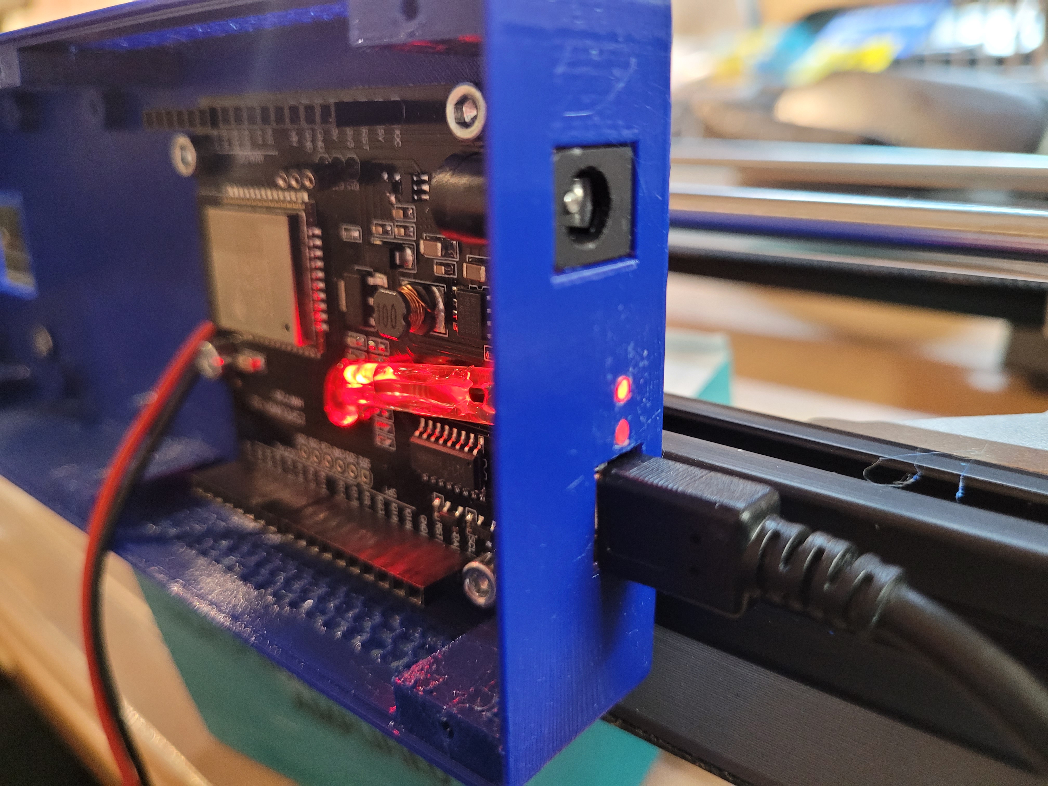
[picture p52: Wemos D1 R32/D1_leds_red.jpg]
D1_leds_red_a


Red and blue led active

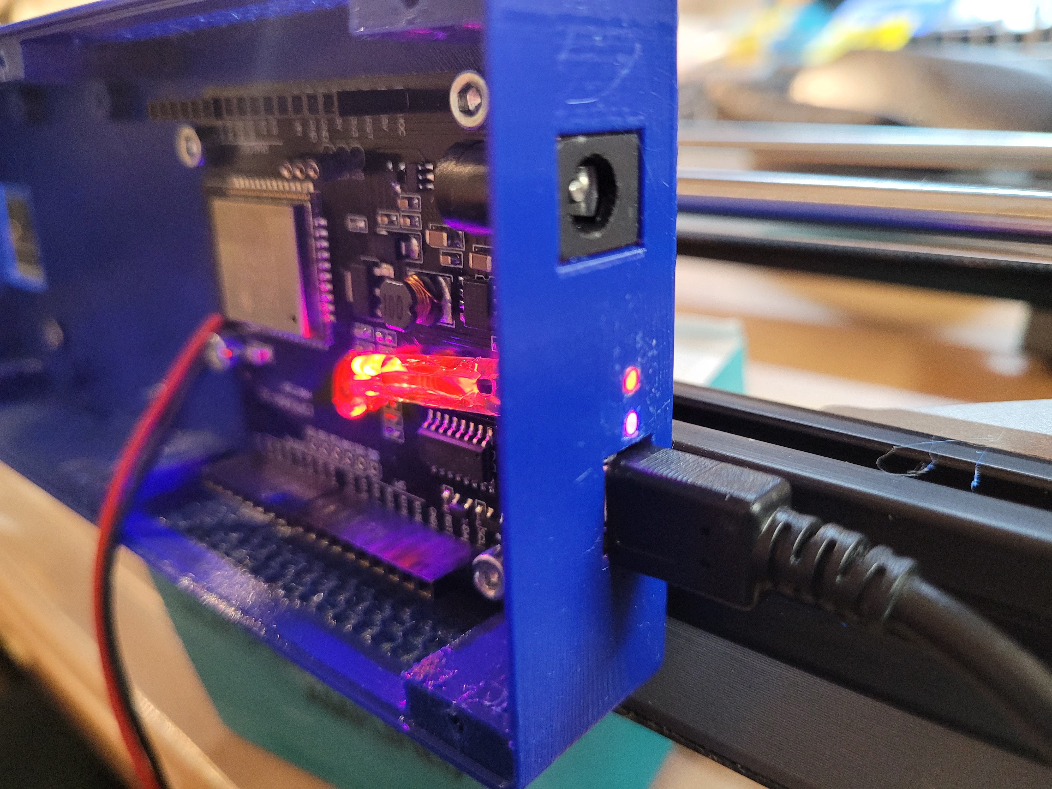
[picture p53: Wemos D1 R32/D1_led_blue.jpg]
D1_led_blue_a


Download movie: Blinking leds

You can also print "ledCover.stl" and use it to fix the fiber optic cables to the board

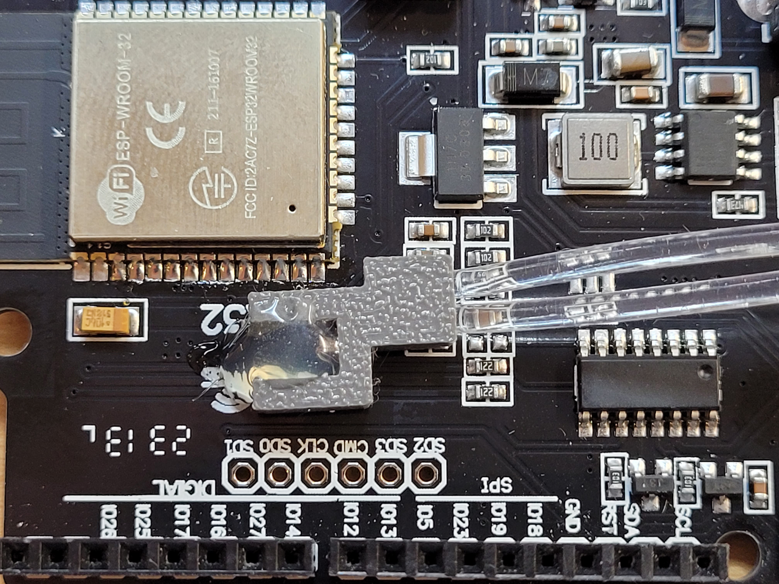
[picture p54: Wemos D1 R32/ledCover_1.jpg]


Detail of "ledCover.stl" fixed with hot glue to the board

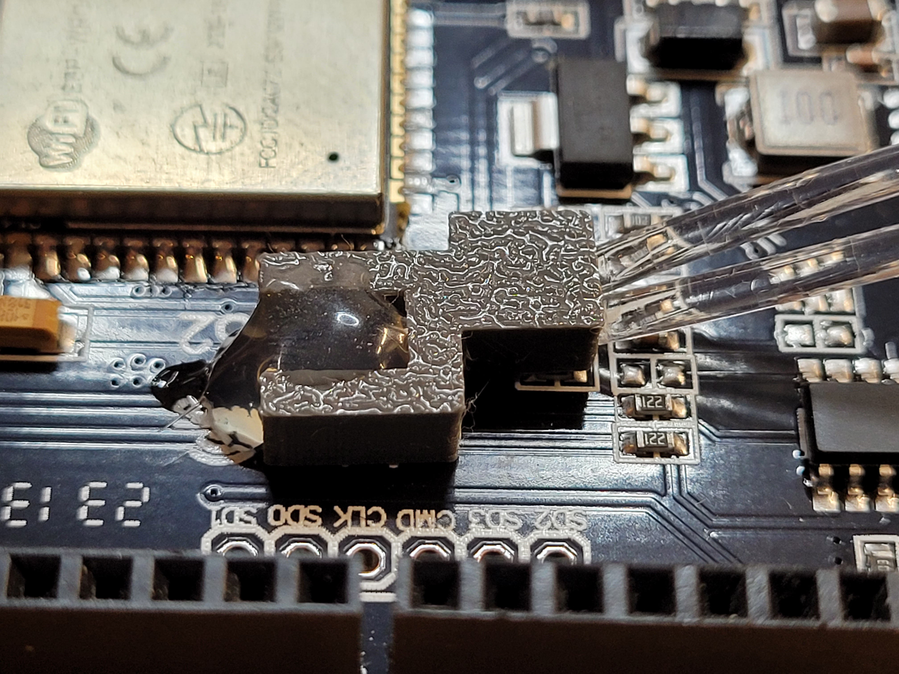
[picture p55: Wemos D1 R32/ledCover_2.jpg]
