refob/herculitoHardware/connectors/README.md

# connectors

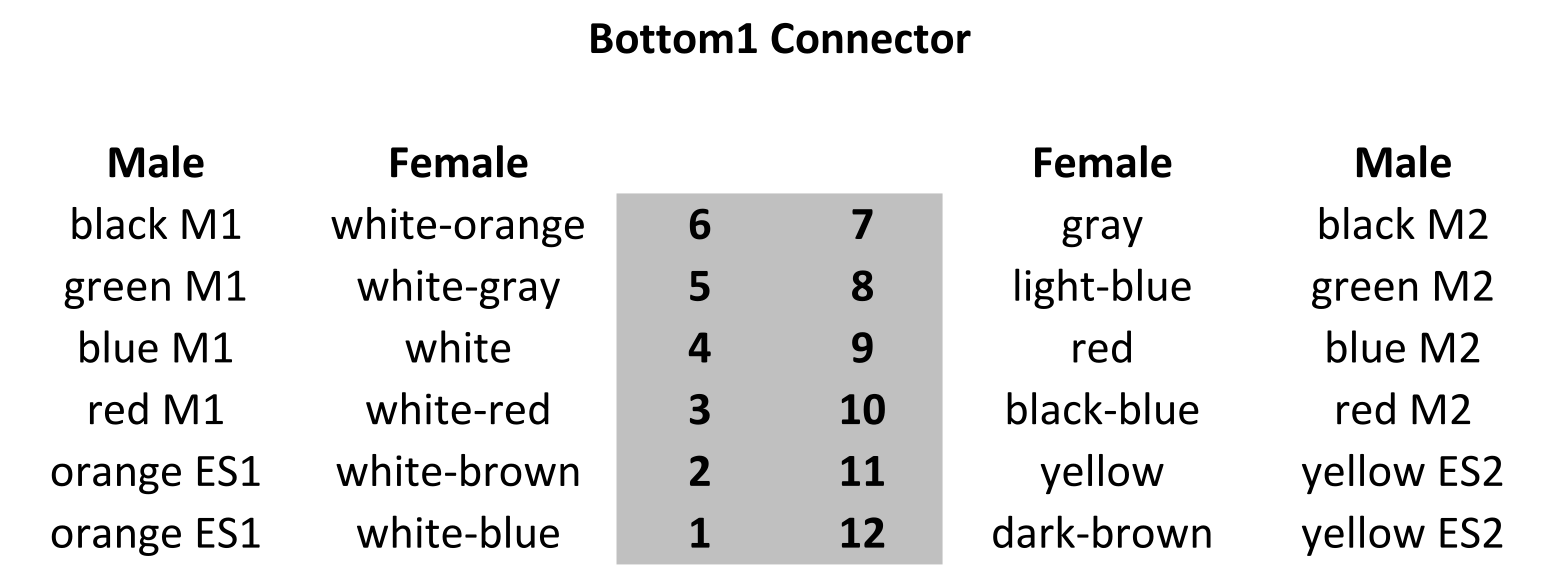
[picture p60: connectors/Bottom1Connector.png]
Bottom1Connector


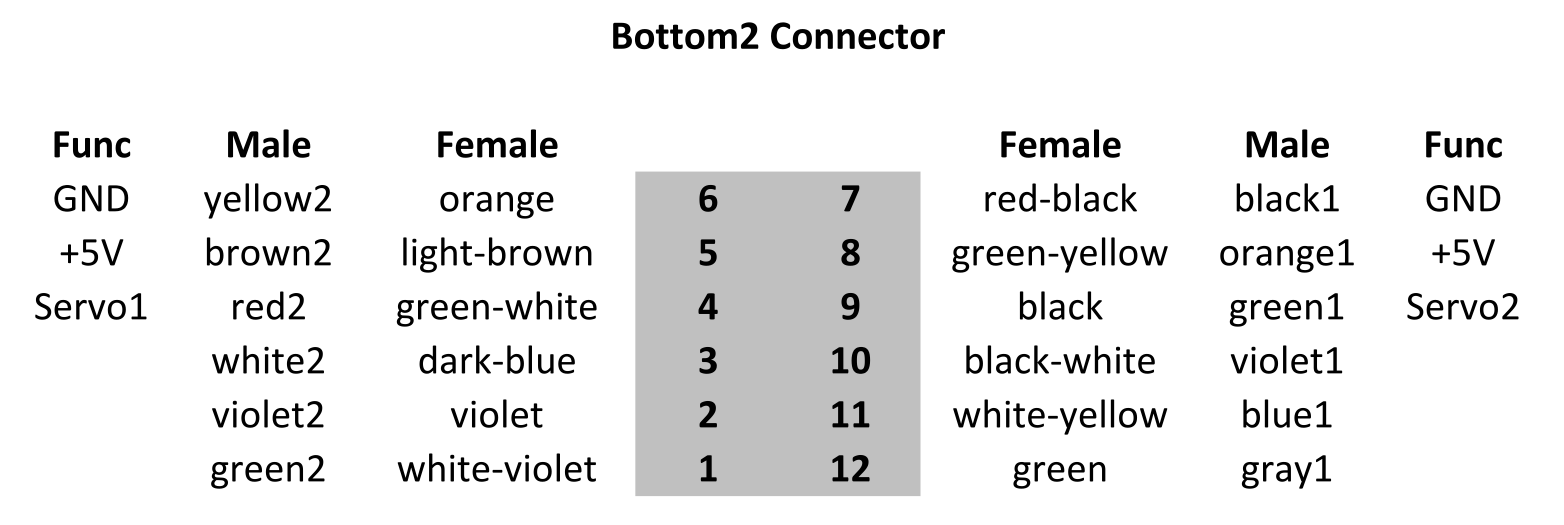
[picture p61: connectors/Bottom2Connector.png]
Bottom2Connector


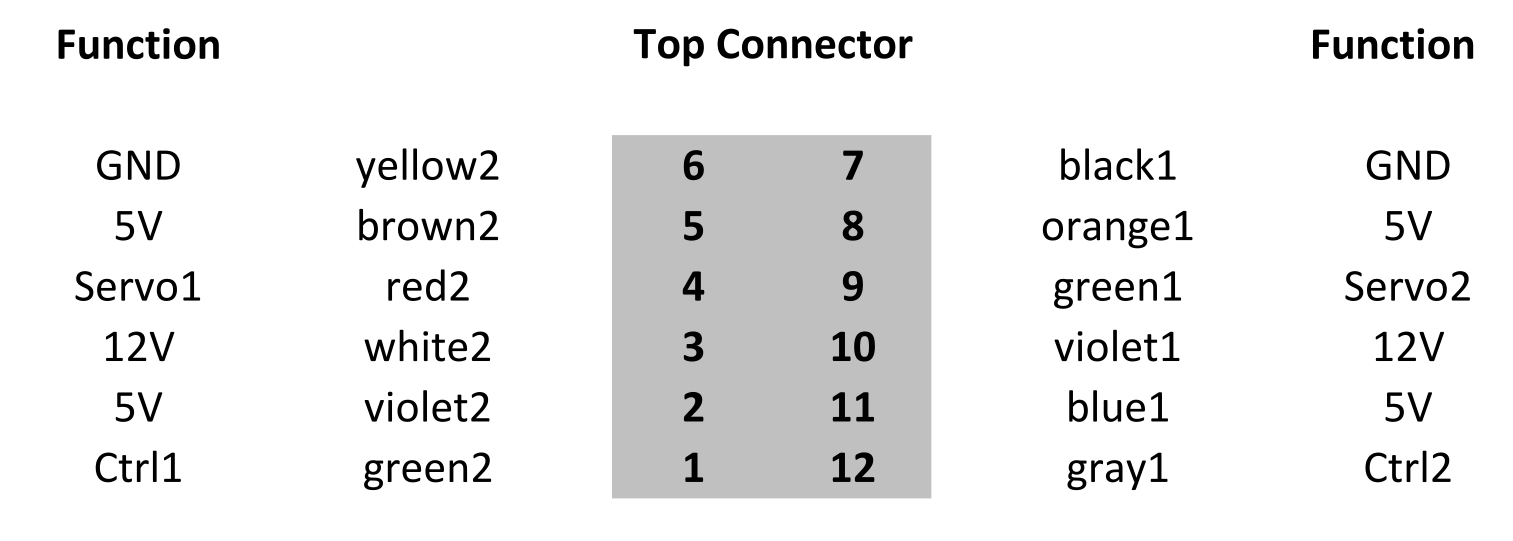
[picture p62: connectors/TopConnector.png]
TopConnector
