refob/herculitoHardware/CNC Shield V3/CNC Shield Modifications.pptx

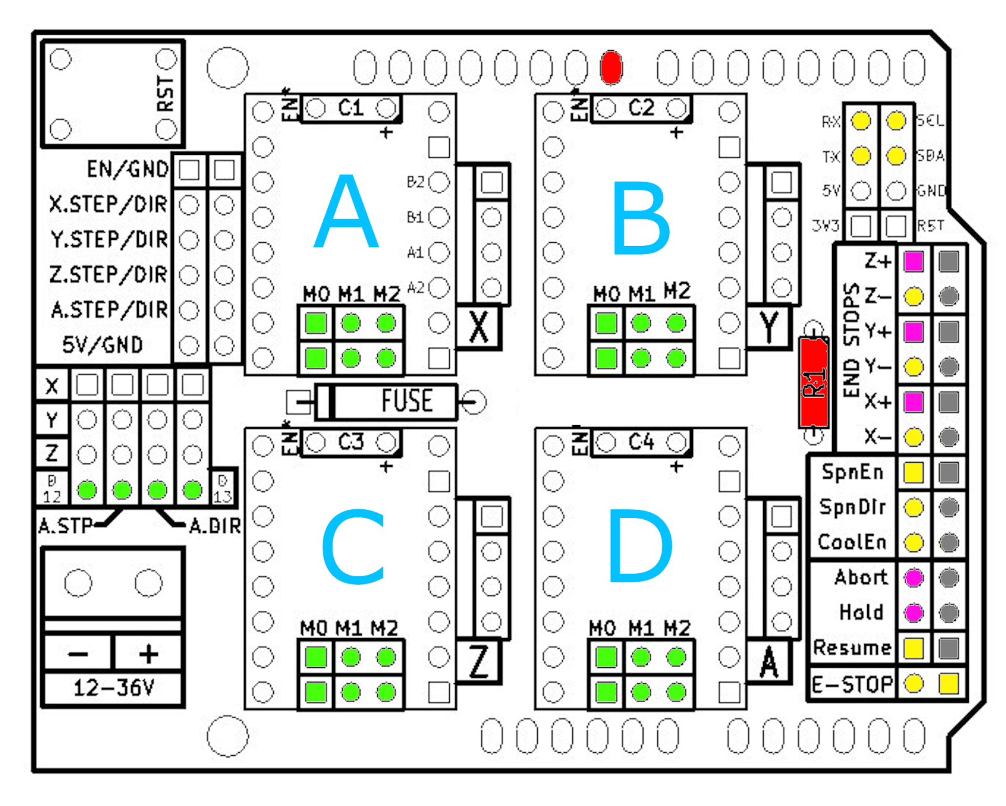
[picture p63: figure]

Beeper

Servo 2

Servo 1

(Step D)

(Dir C)

(Endstop C)

(Blue LED)

Ctrl1

(Endstop D)

External Reset

Insert
Jumper

Hardware
Modification

Fixed Function

Flexible
Function

Stepper
Indentification
