refob/herculitoHardware/connectors/TopConnector.pdf

Function | | | | | Function
GND | yellow2 | 6 | 7 | black1 | GND
5V | brown2 | 5 | 8 | orange1 | 5V
Servo1 | red2 | 4 | 9 | green1 | Servo2
12V | white2 | 3 | 10 | violet1 | 12V
5V | violet2 | 2 | 11 | blue1 | 5V
Ctrl1 | green2 | 1 | 12 | gray1 | Ctrl2

Top Connector
