refob/herculitoHardware/connectors/Bottom1Connector.pdf

Male | Female | | | Female | Male
black M1 | white-orange | 6 | 7 | gray | black M2
green M1 | white-gray | 5 | 8 | light-blue | green M2
blue M1 | white | 4 | 9 | red | blue M2
red M1 | white-red | 3 | 10 | black-blue | red M2
orange ES1 | white-brown | 2 | 11 | yellow | yellow ES2
orange ES1 | white-blue | 1 | 12 | dark-brown | yellow ES2

Bottom1 Connector
