refob/herculitoHardware/connectors/Bottom2Connector.pdf

Func | Male | Female | | | Female | Male | Func
GND | yellow2 | orange | 6 | 7 | red-black | black1 | GND
+5V | brown2 | light-brown | 5 | 8 | green-yellow | orange1 | +5V
Servo1 | red2 | green-white | 4 | 9 | black | green1 | Servo2
| white2 | dark-blue | 3 | 10 | black-white | violet1
| violet2 | violet | 2 | 11 | white-yellow | blue1
| green2 | white-violet | 1 | 12 | green | gray1

Bottom2 Connector
