refob/herculitoHardware/InterConn/InterConn-Connections.pdf

Net | Pin | Pin | Net | Function | Color
GND | 24 | 23 | GPIO39 | Endstop A | yellow
GND | 22 | 21 | GPIO36 | Endstop B | yellow
GND | 20 | 19 | GPIO34 | Endstop C | yellow
GND | 18 | 17 | GPIO35 | Endstop D | yellow
GND | 16 | 15 | GPIO32 | LedCtrl | green
GND | 14 | 13 | GPIO33 | RS | blue
GND | 12 | 11 | GPIO15 | CS | orange
GND | 10 | 9 | - | -
GND | 8 | 7 | - | -
GND | 6 | 5 | - | -
GND | 4 | 3 | GPIO22 | SCL | violet
GND | 2 | 1 | GPIO21 | SDA | green
