refob/herculitoHardware/InterConn/3pin d.jpg

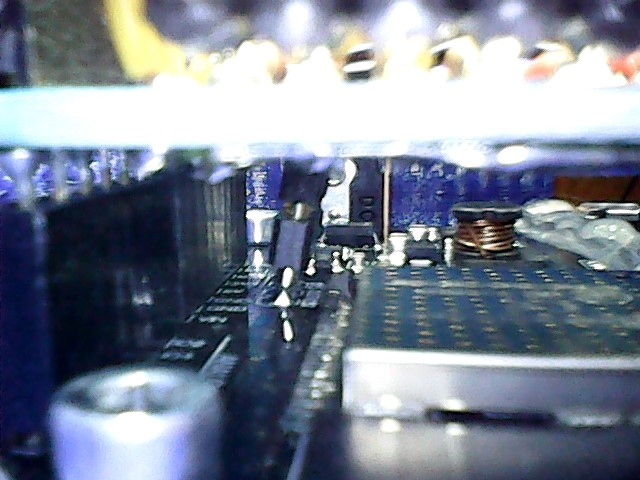
InterConn/3pin d.jpg
