refob/herculitoHardware/InterConn/pcbSpacer.stl

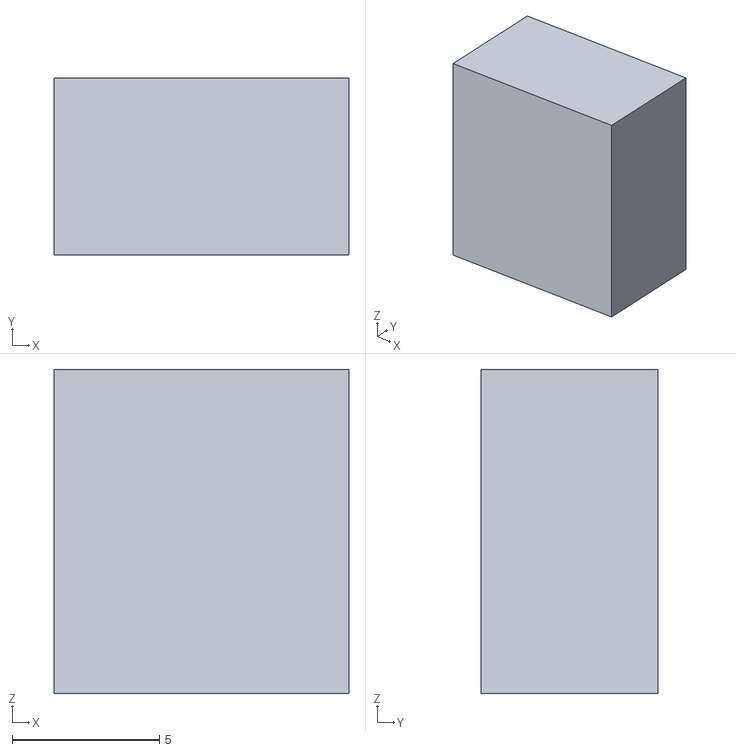
[picture p65: CAD file, 2024-01-30]
InterConn/pcbSpacer.stl
10.0 x 6.00 x 11.0
