refob/herculitoHardware/Wemos D1 R32/ledCover.stl

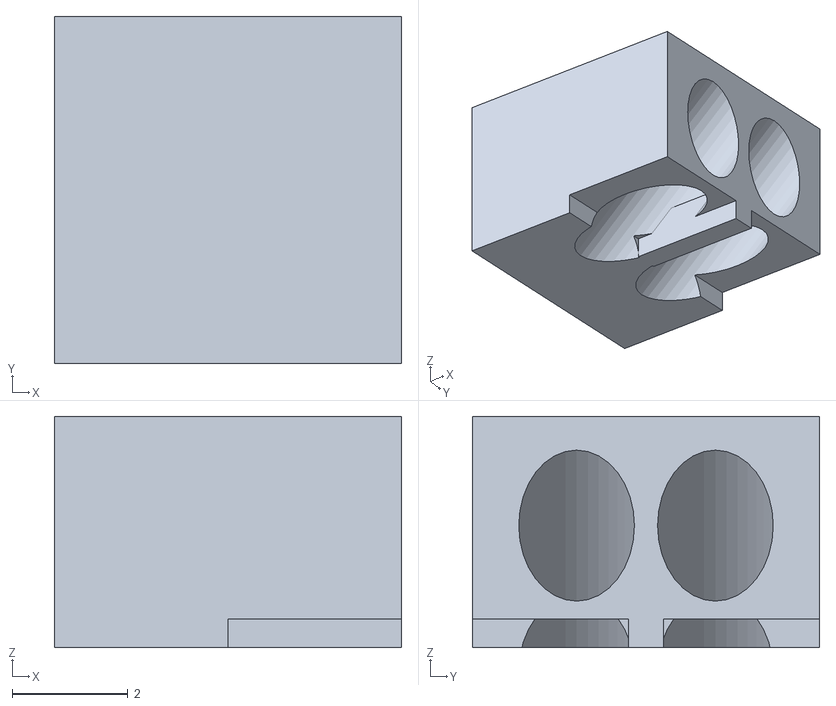
[picture p66: CAD file, 2024-01-30]
Wemos D1 R32/ledCover.stl
6.00 x 6.00 x 4.00
