refob/herculitoHardware/KiCad/Display/Display.kicad_sch

## KiCad design KiCad/Display/Display.kicad_sch (2024-01-14)

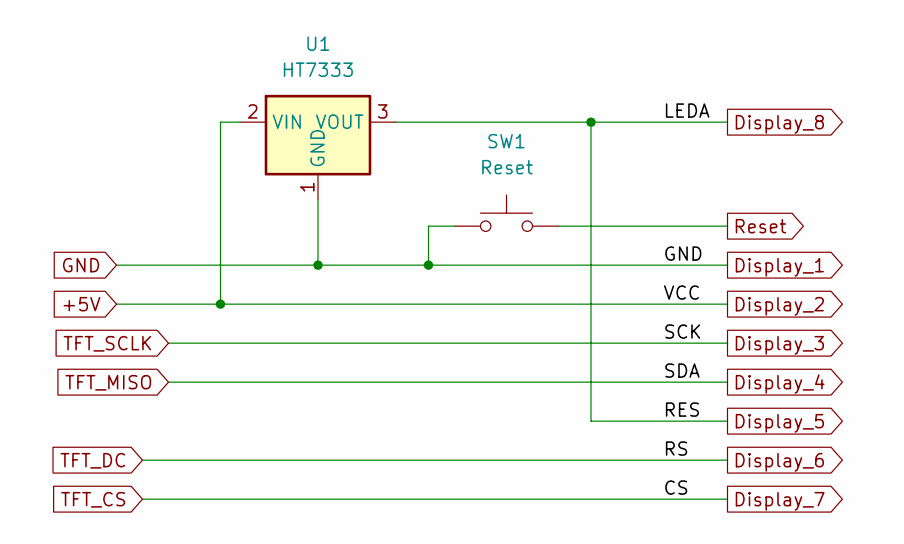
[picture p67: schematic Display.kicad_sch]

Parts:
SW1: Reset
U1: HT7333; SOT-89-3

Connections:
+5V: U1.2 (VIN)
Display_1: SW1.1, U1.1 (GND)
Display_5: U1.3 (VOUT)
Reset: SW1.2
