refob/herculitoHardware/KiCad/Extension/Extension.kicad_sch

## KiCad design KiCad/Extension/Extension.kicad_sch (2024-01-14)

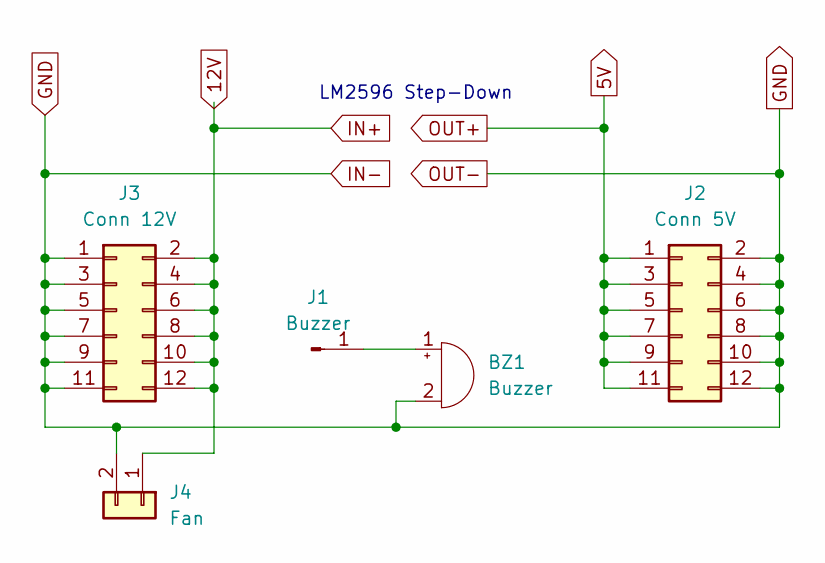
[picture p68: schematic Extension.kicad_sch]

Parts:
BZ1: Buzzer
J1: Buzzer
J2: Conn 5V
J3: Conn 12V
J4: Fan

Connections:
5V: J2.1, J2.3, J2.5, J2.7, J2.9, J2.11
12V: J3.2, J3.4, J3.6, J3.8, J3.10, J3.12, J4.1
GND: BZ1.2 (+), J2.2, J2.4, J2.6, J2.8, J2.10, J2.12, J3.1, J3.3, J3.5, J3.7, J3.9, J3.11, J4.2
unnamed: BZ1.1 (-), J1.1

Notes on the sheet:
LM2596 Step-Down
