refob/herculitoHardware/KiCad/InterConn/InterConn.kicad_sch

## KiCad design KiCad/InterConn/InterConn.kicad_sch (2024-01-12)

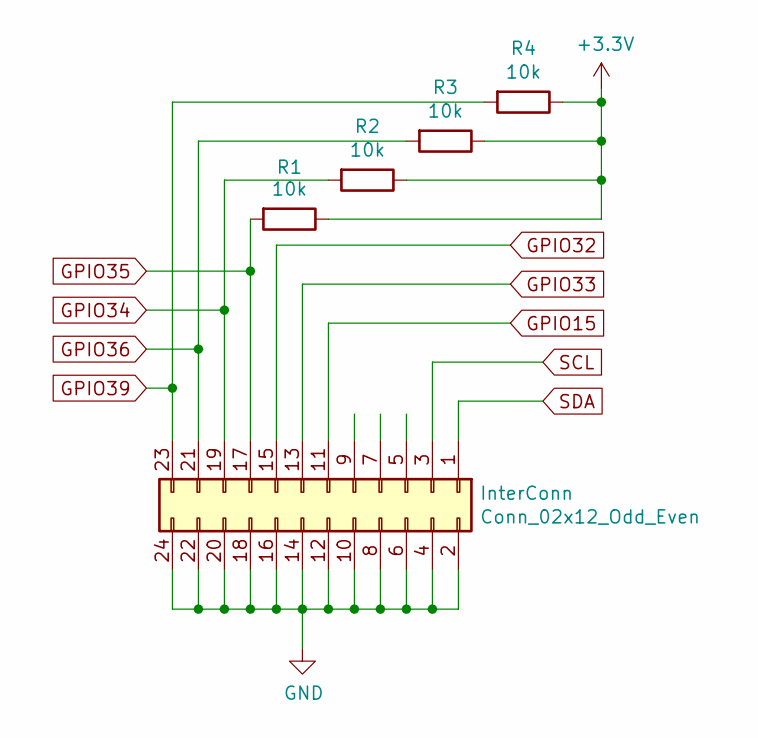
[picture p69: schematic InterConn.kicad_sch]

Parts:
InterConn: Conn_02x12_Odd_Even
R1, R2, R3, R4: 10k

Connections:
GPIO15: InterConn.11
GPIO32: InterConn.15
GPIO33: InterConn.13
GPIO34: InterConn.19, R2.2
GPIO35: InterConn.17, R1.2
GPIO36: InterConn.21, R3.2
GPIO39: InterConn.23, R4.2
unnamed: InterConn.2, InterConn.4, InterConn.6, InterConn.8, InterConn.10, InterConn.12, InterConn.14, InterConn.16, InterConn.18, InterConn.20, InterConn.22, InterConn.24
unnamed: R1.1, R2.1, R3.1, R4.1
SCL: InterConn.3
SDA: InterConn.1
