refob/herculitoHardware/(commit log)

2024-01-12 InterConn schematic created
    [InterConn.kicad_sch]
2024-01-14 Rename dir
    [InterConn.kicad_sch]
2024-01-14 rename images
    [Weemos CNC30 UNO Mapping.xlsx]
2024-01-30 Added ledCover
    [ledCover.stl]
2024-01-30 pcbSpacer added
    [pcbSpacer.stl]
2024-01-30 Pin glued
2024-05-22 MOS Switch Extension
