refob/herculitoHardware/CNC Shield V3/enable a.jpg

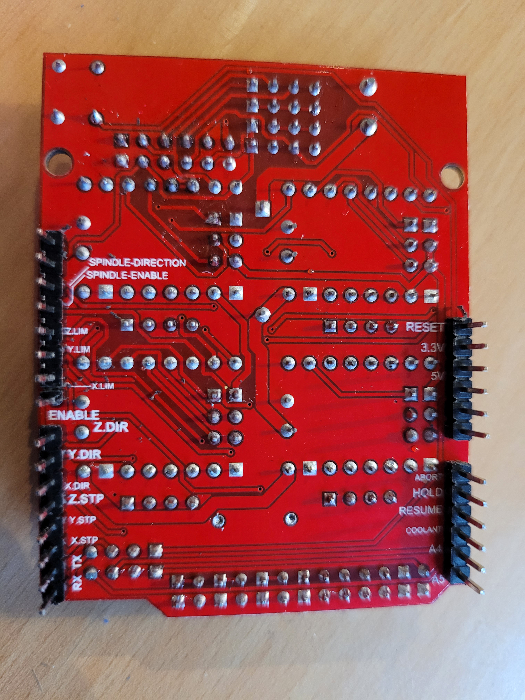
[picture p20: CNC Shield V3/enable a.jpg]
CNC Shield V3/enable a.jpg
