refob/herculitoHardware/CNC Shield V3/enable d.jpg

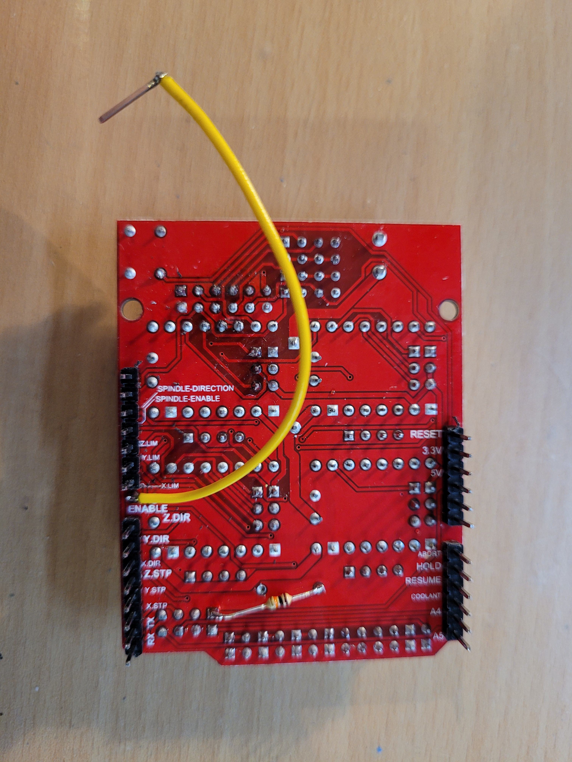
[picture p23: CNC Shield V3/enable d.jpg]
CNC Shield V3/enable d.jpg
