refob/herculitoHardware/Wemos D1 R32/D1 power b.jpg

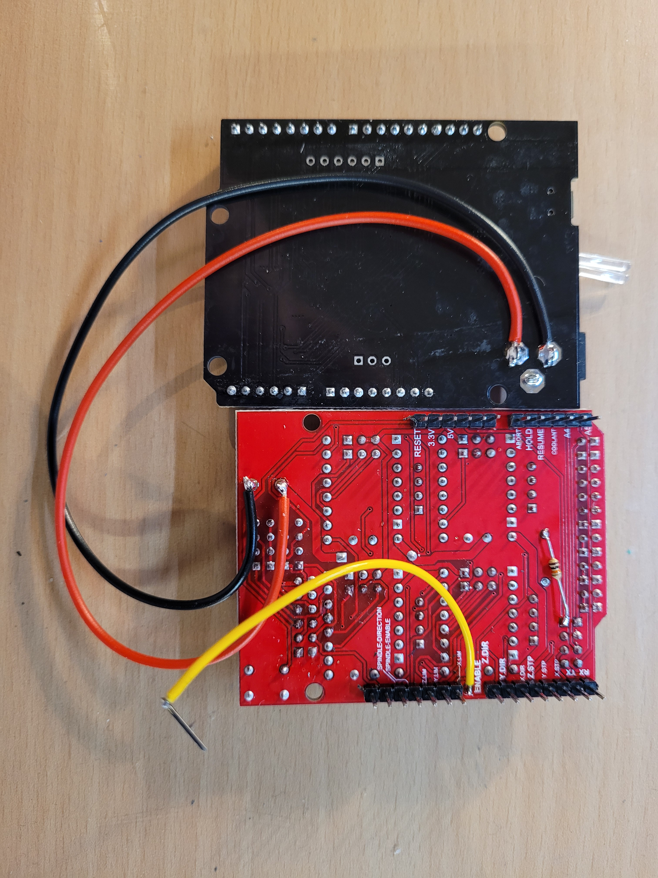
[picture p47: Wemos D1 R32/D1_power_b.jpg]
Wemos D1 R32/D1 power b.jpg
